elkel53930/daylight/elec/main_board/main_board_outline.dxf

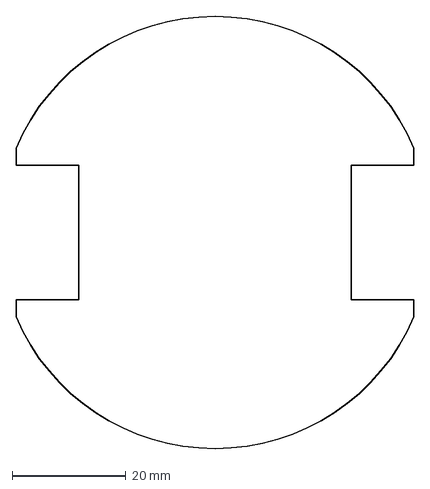
[picture p1: CAD file, 2026-06-27]
elec/main_board/main_board_outline.dxf
70.0 x 76.0 mm
