elkel53930/daylight/elec/main_board/encoder_board_outline.dxf

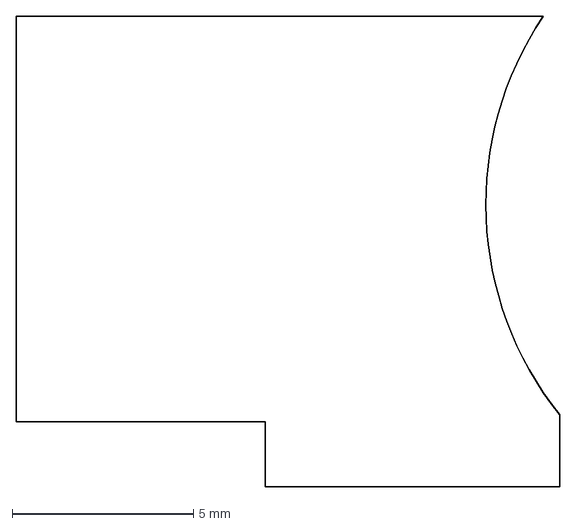
[picture p3: CAD file, 2026-06-28]
elec/main_board/encoder_board_outline.dxf
15.0 x 13.0 mm
