elkel53930/daylight/elec/rpi_board/rpi_board_outline.dxf

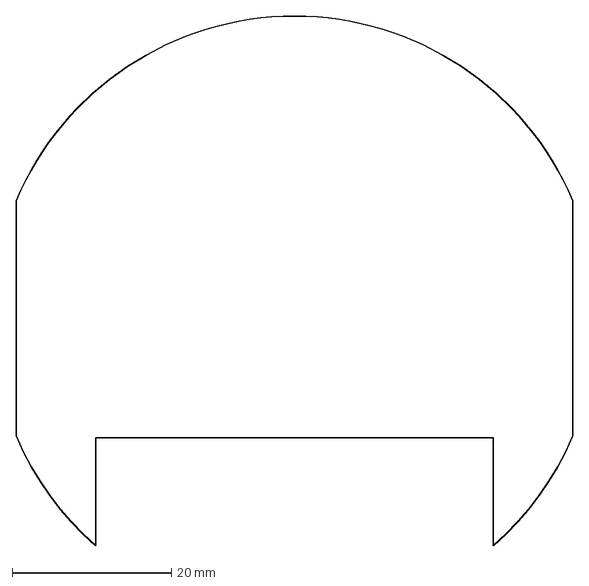
[picture p6: CAD file, 2026-06-28]
elec/rpi_board/rpi_board_outline.dxf
70.0 x 66.6 mm
