elkel53930/daylight/elec/sub_boards/encoder_board_outline.dxf

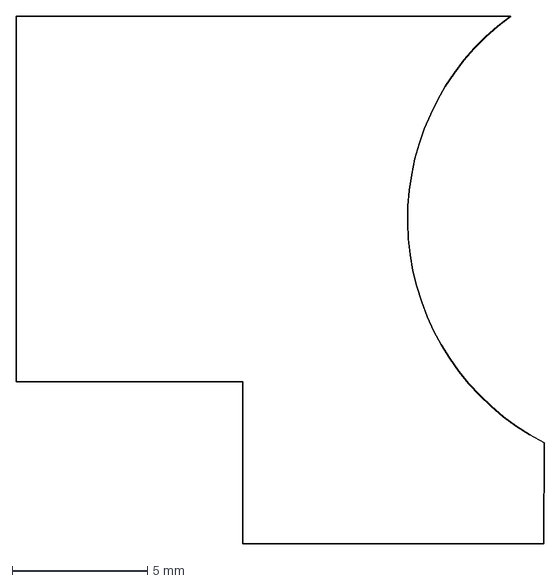
[picture p7: CAD file, 2026-07-31]
elec/sub_boards/encoder_board_outline.dxf
19.5 x 19.5 mm
