elkel53930/daylight/elec/sub_boards/if_board_outline.dxf

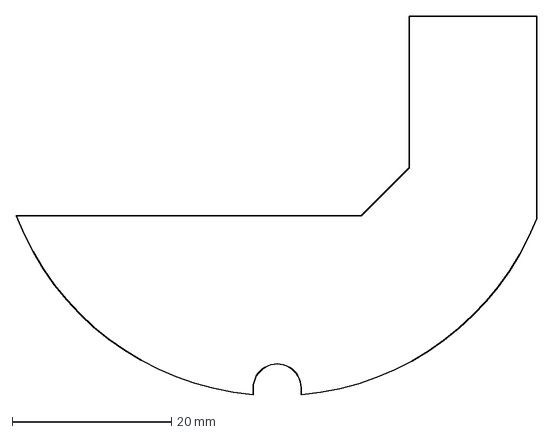
[picture p8: CAD file, 2026-06-28]
elec/sub_boards/if_board_outline.dxf
65.3 x 47.4 mm
