elkel53930/daylight/elec/main_board/encoder_board_drawing.dxf

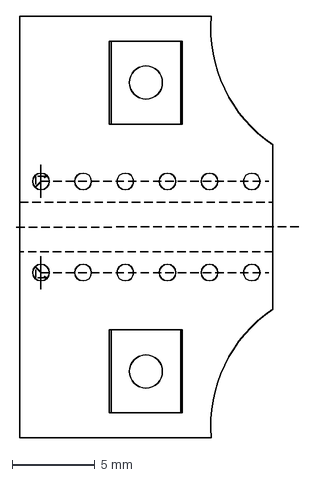
[picture p9: CAD file, 2026-05-14]
elec/main_board/encoder_board_drawing.dxf
17.0 x 25.4 mm
