elkel53930/daylight/elec/sub_boards/if_board_drawing.dxf

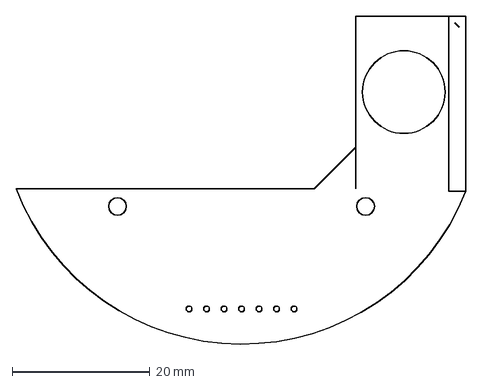
[picture p10: CAD file, 2026-06-28]
elec/sub_boards/if_board_drawing.dxf
65.3 x 47.7 mm
