elkel53930/daylight/elec/sub_boards/sub_boards.kicad_pcb

## KiCad design elec/sub_boards/sub_boards.kicad_pcb (2026-08-02)

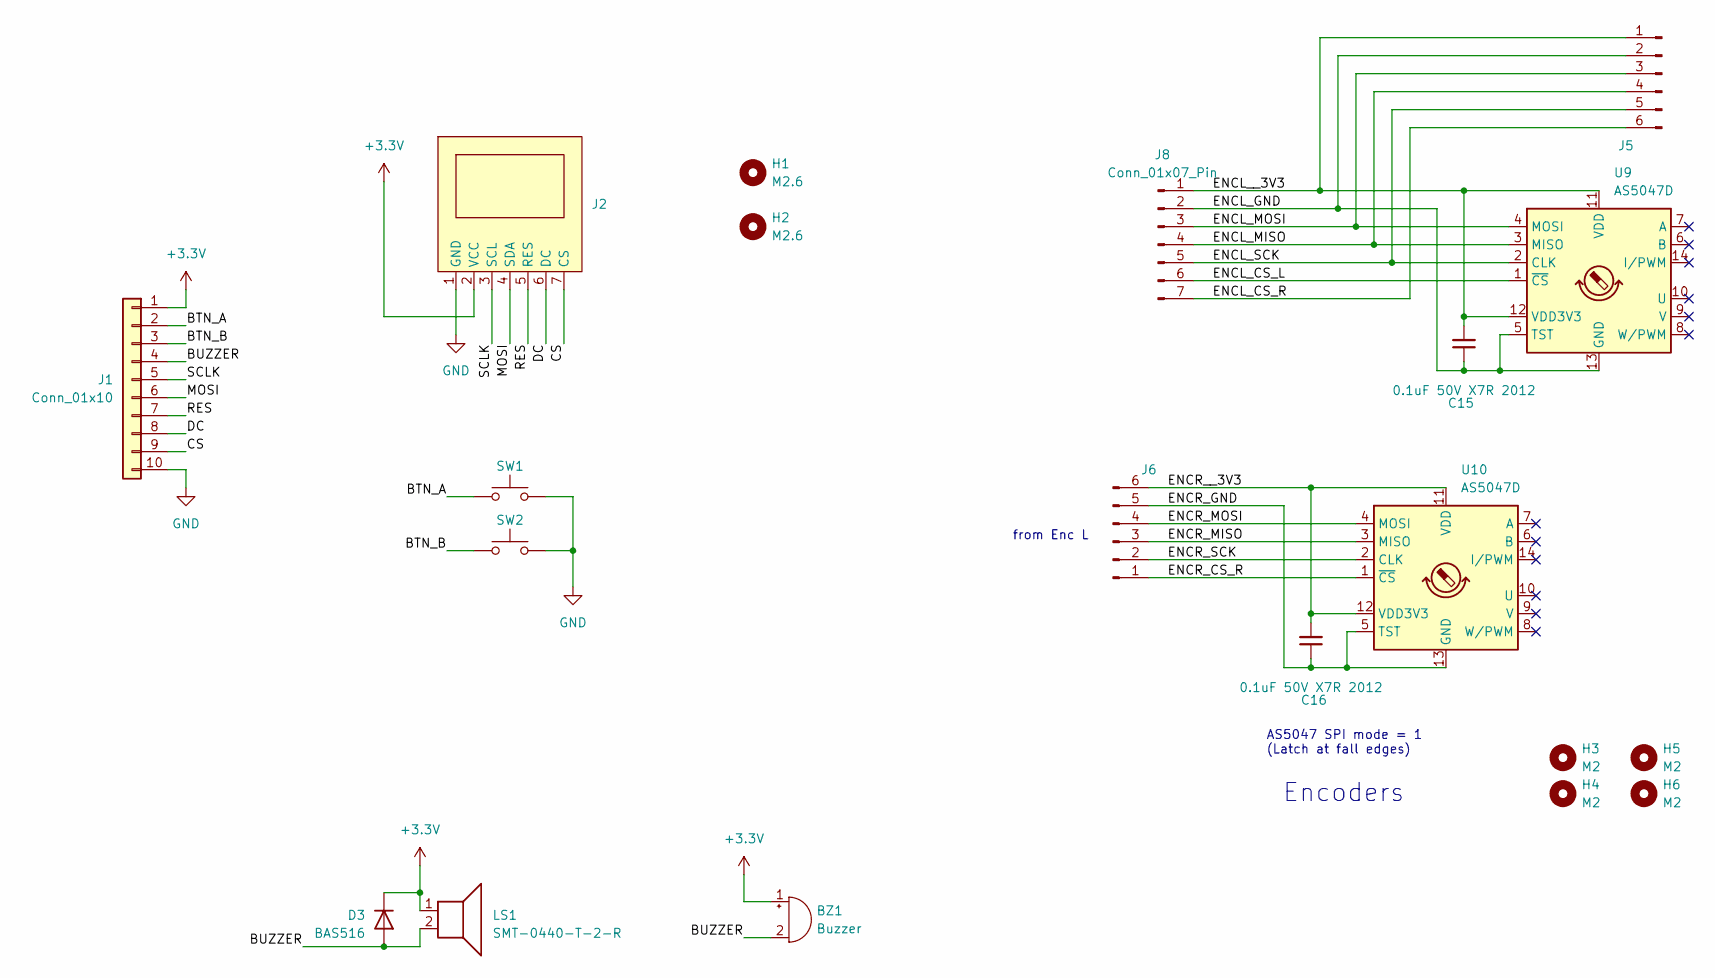
[picture p11: schematic sub_boards.kicad_sch]

Parts:
BZ1: Buzzer; Buzzer_12x9.5RM7.6
C15, C16: C_0805_2012Metric_Pad1.18x1.45mm_HandSolder
D3: BAS516; D_SOD-523
H1, H2: M2.6; MountingHole_2.7mm
H3, H4, H5, H6: M2; MountingHole_2.1mm
J1: Conn_01x10; PinSocket_1x10_P2.54mm_Vertical
J2: PinSocket_1x07_P2.54mm_Vertical
J5, J6: PSR-41253-06O; JST_ZH_B6B-ZR_1x06_P1.50mm_Vertical
J8: Conn_01x07_Pin; JST_ZH_B7B-ZR_1x07_P1.50mm_Vertical
LS1: SMT-0440-T-2-R
SW1, SW2: TVBP06-B043CB-B; SW_PUSH_1P1T_6x3.5mm_H4.3_APEM_MJTP1243
U9, U10: AS5047D; TSSOP-14_4.4x5mm_P0.65mm

Connections:
+3.3V: BZ1.1 (+), D3.1 (K), J1.1, J2.2 (VCC), LS1.1
/BTN_A: J1.2, SW1.1
/BTN_B: J1.3, SW2.1
/BUZZER: BZ1.2 (-), D3.2 (A), J1.4, LS1.2
/CS: J1.9, J2.7 (CS)
/DC: J1.8, J2.6 (DC)
/ENCL_CS_L: J8.6, U9.1 (~CS)
/ENCL_CS_R: J5.6, J8.7
/ENCL_GND: C15.1, J5.2, J8.2, U9.5 (TST), U9.13 (GND)
/ENCL_MISO: J5.4, J8.4, U9.3 (MISO)
/ENCL_MOSI: J5.3, J8.3, U9.4 (MOSI)
/ENCL_SCK: J5.5, J8.5, U9.2 (CLK)
/ENCL__3V3: C15.2, J5.1, J8.1, U9.11 (VDD), U9.12 (VDD3V3)
/ENCR_CS_R: J6.1, U10.1 (~CS)
/ENCR_GND: C16.1, J6.5, U10.5 (TST), U10.13 (GND)
/ENCR_MISO: J6.3, U10.3 (MISO)
/ENCR_MOSI: J6.4, U10.4 (MOSI)
/ENCR_SCK: J6.2, U10.2 (CLK)
/ENCR__3V3: C16.2, J6.6, U10.11 (VDD), U10.12 (VDD3V3)
/MOSI: J1.6, J2.4 (SDA)
/RES: J1.7, J2.5 (RES)
/SCLK: J1.5, J2.3 (SCL)
GND: J1.10, J2.1 (GND), SW1.2, SW2.2

Notes on the sheet:
AS5047 SPI mode = 1 (Latch at fall edges)
from Enc L
Encoders

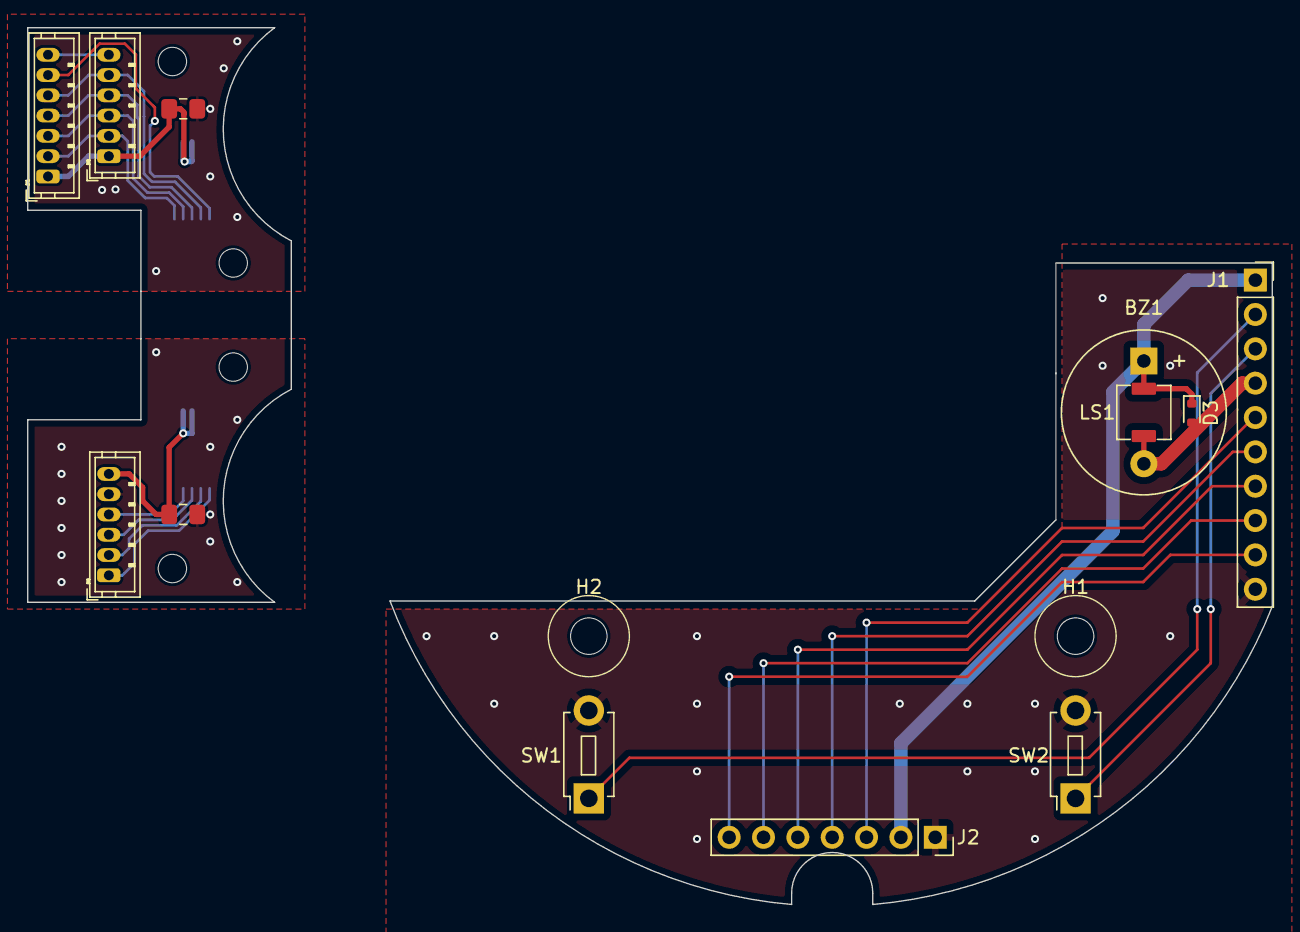
[picture p12: board sub_boards.kicad_pcb from above]

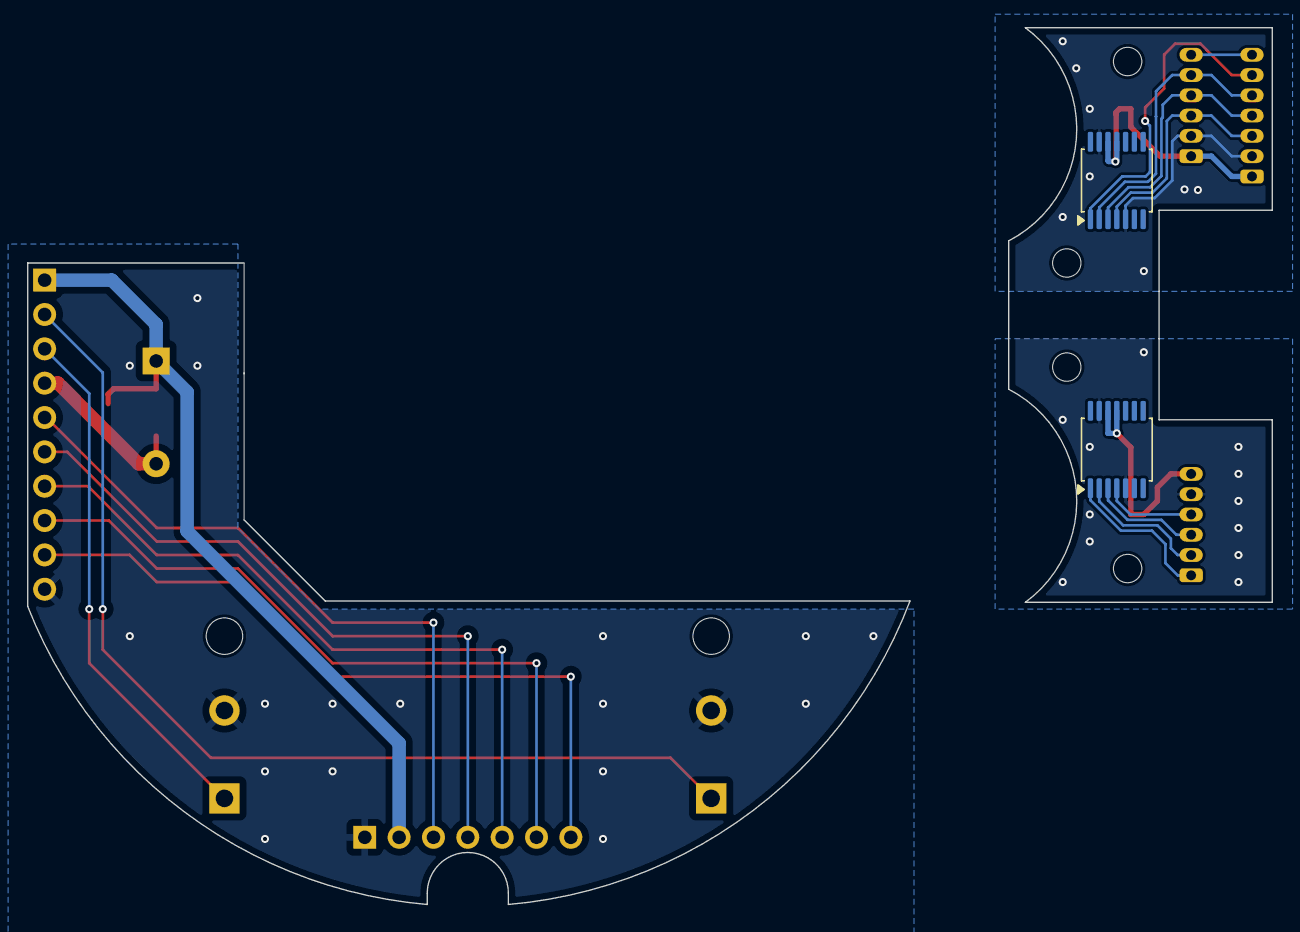
[picture p13: board sub_boards.kicad_pcb from below]

Board: 2 copper layers, 92.0 x 64.8 mm, 20 parts (2 on the bottom side), 23 nets.
