elkel53930/daylight/elec/rpi_board/rpi_board.kicad_pcb

## KiCad design elec/rpi_board/rpi_board.kicad_pcb (2026-06-29)

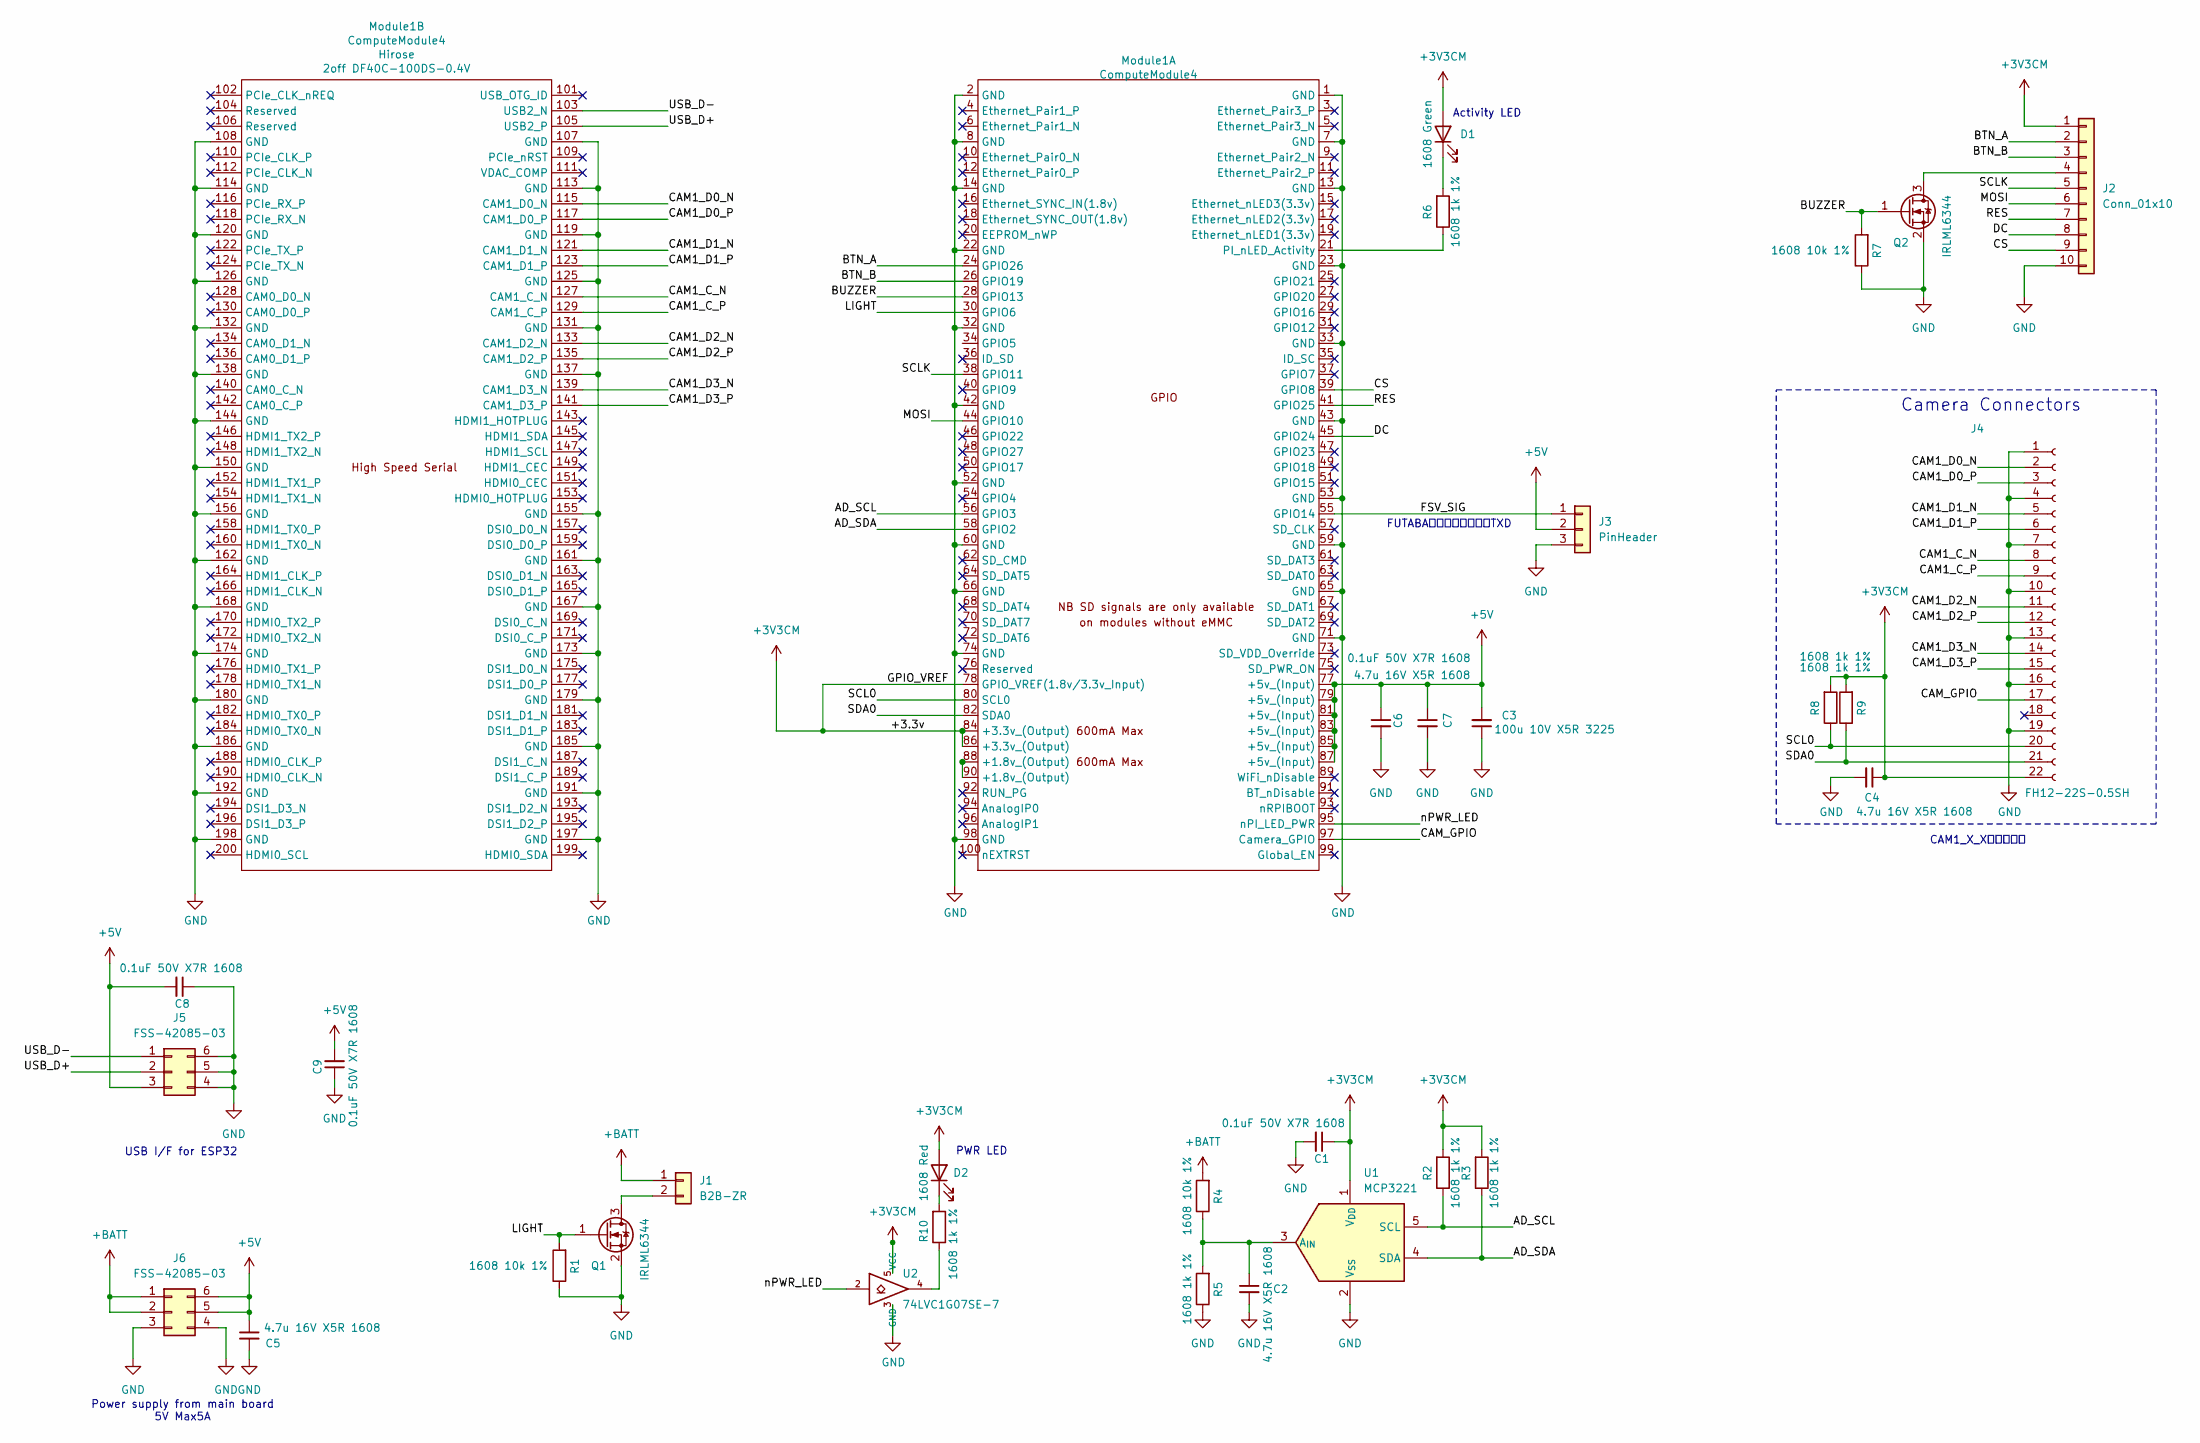
[picture p14: schematic rpi_board.kicad_sch]

Parts:
C1, C6, C8, C9: CC0603KRX7R9BB104; C_0603_1608Metric
C2, C4, C5, C7: CL10A475KO8NNNC; C_0603_1608Metric
C3: CL32A107MPVNNNE; C_1210_3225Metric
D1: D-060306G1/SS2/G1; LED_0603_1608Metric
D2: KT-0603R; LED_0603_1608Metric
J1: B2B-ZR; JST_ZH_B2B-ZR_1x02_P1.50mm_Vertical
J2: Conn_01x10; PinSocket_1x10_P2.54mm_Vertical
J3: PinHeader; PinHeader_1x03_P2.54mm_Vertical
J4: FH12-22S-0.5SH; Hirose_FH12-22S-0.5SH_1x22-1MP_P0.50mm_Horizontal; Part Description 22 Position FFC, FPC Connector Contacts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
J5, J6: FSS-42085-03; PinHeader_2x03_P2.54mm_Vertical
Module1: ComputeModule4; Raspberry-Pi-4-Compute-Module; Part Description 100 Position Connector Receptacle, Cent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
Q1, Q2: IRLML6344; SOT-23
R1, R4, R7: 0603WAF1002T5E; R_0603_1608Metric
R2, R3, R5, R6, R8, R9, R10: 0603WAF1001T5E; R_0603_1608Metric
U1: MCP3221; SOT-23-5
U2: 74LVC1G07SE-7; SOT-353_SC-70-5; Part Description Buffer, Non-Inverting 1 Element 1 Bit p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

Connections:
+3V3CM: C1.1, C4.1, D1.2 (A), D2.2 (A), J2.1, J4.22, Module1.78 (GPIO_VREF(1.8v/3.3v_Input)), Module1.84 (+3.3v_(Output)), Module1.86 (+3.3v_(Output)), R2.2, R3.2, R8.2, R9.2, U1.1 (V_{DD}), U2.5 (VCC)
+5V: C3.2, C5.1, C6.1, C7.1, C8.2, C9.2, J3.2, J5.3, J6.5, J6.6, Module1.77 (+5v_(Input)), Module1.79 (+5v_(Input)), Module1.81 (+5v_(Input)), Module1.83 (+5v_(Input)), Module1.85 (+5v_(Input)), Module1.87 (+5v_(Input))
+BATT: J1.1, J6.1, J6.2, R4.2
/AD_SCL: Module1.56 (GPIO3), R2.1, U1.5 (SCL)
/AD_SDA: Module1.58 (GPIO2), R3.1, U1.4 (SDA)
/BTN_A: J2.2, Module1.24 (GPIO26)
/BTN_B: J2.3, Module1.26 (GPIO19)
/BUZZER: Module1.28 (GPIO13), Q2.1 (G), R7.2
/CAM1_C_N: J4.8, Module1.127 (CAM1_C_N)
/CAM1_C_P: J4.9, Module1.129 (CAM1_C_P)
/CAM1_D0_N: J4.2, Module1.115 (CAM1_D0_N)
/CAM1_D0_P: J4.3, Module1.117 (CAM1_D0_P)
/CAM1_D1_N: J4.5, Module1.121 (CAM1_D1_N)
/CAM1_D1_P: J4.6, Module1.123 (CAM1_D1_P)
/CAM1_D2_N: J4.11, Module1.133 (CAM1_D2_N)
/CAM1_D2_P: J4.12, Module1.135 (CAM1_D2_P)
/CAM1_D3_N: J4.14, Module1.139 (CAM1_D3_N)
/CAM1_D3_P: J4.15, Module1.141 (CAM1_D3_P)
/CAM_GPIO: J4.17, Module1.97 (Camera_GPIO)
/CS: J2.9, Module1.39 (GPIO8)
/DC: J2.8, Module1.45 (GPIO24)
/FSV_SIG: J3.1, Module1.55 (GPIO14)
/LIGHT: Module1.30 (GPIO6), Q1.1 (G), R1.2
/MOSI: J2.6, Module1.44 (GPIO10)
/RES: J2.7, Module1.41 (GPIO25)
/SCL0: J4.20, Module1.80 (SCL0), R8.1
/SCLK: J2.5, Module1.38 (GPIO11)
/SDA0: J4.21, Module1.82 (SDA0), R9.1
/USB_D+: J5.2, Module1.105 (USB2_P)
/USB_D-: J5.1, Module1.103 (USB2_N)
/nPWR_LED: Module1.95 (nPI_LED_PWR), U2.2
GND: C1.2, C2.2, C3.1, C4.2, C5.2, C6.2, C7.2, C8.1, C9.1, J2.10, J3.3, J4.1, J4.4, J4.7, J4.10, J4.13, J4.16, J4.19, J5.4, J5.5, J5.6, J6.3, J6.4, Module1.1 (GND), Module1.2 (GND), Module1.7 (GND), Module1.8 (GND), Module1.13 (GND), Module1.14 (GND), Module1.22 (GND), Module1.23 (GND), Module1.32 (GND), Module1.33 (GND), Module1.42 (GND), Module1.43 (GND), Module1.52 (GND), Module1.53 (GND), Module1.59 (GND), Module1.60 (GND), Module1.65 (GND), Module1.66 (GND), Module1.71 (GND), Module1.74 (GND), Module1.98 (GND), Module1.107 (GND), Module1.108 (GND), Module1.113 (GND), Module1.114 (GND), Module1.119 (GND), Module1.120 (GND), Module1.125 (GND), Module1.126 (GND), Module1.131 (GND), Module1.132 (GND), Module1.137 (GND), Module1.138 (GND), Module1.144 (GND), Module1.150 (GND), Module1.155 (GND), Module1.156 (GND), Module1.161 (GND), Module1.162 (GND), Module1.167 (GND), Module1.168 (GND), Module1.173 (GND), Module1.174 (GND), Module1.179 (GND), Module1.180 (GND), Module1.185 (GND), Module1.186 (GND), Module1.191 (GND), Module1.192 (GND), Module1.197 (GND), Module1.198 (GND), Q1.2 (S), Q2.2 (S), R1.1, R5.1, R7.1, U1.2 (V_{SS}), U2.3 (GND)
unnamed: D1.1 (K), R6.2
unnamed: D2.1 (K), R10.2
unnamed: J1.2, Q1.3 (D)
unnamed: J2.4, Q2.3 (D)
unnamed: Module1.88 (+1.8v_(Output)), Module1.90 (+1.8v_(Output))
unnamed: Module1.21 (PI_nLED_Activity), R6.1
unnamed: R10.1, U2.4
unnamed: C2.1, R4.1, R5.2, U1.3 (A_{IN})

Notes on the sheet:
CAM1_X_Xは等長配線
Camera Connectors
PWR LED
Activity LED
Power supply from main board 5V Max5A
FUTABAサーボモータ用のTXD
USB I/F for ESP32

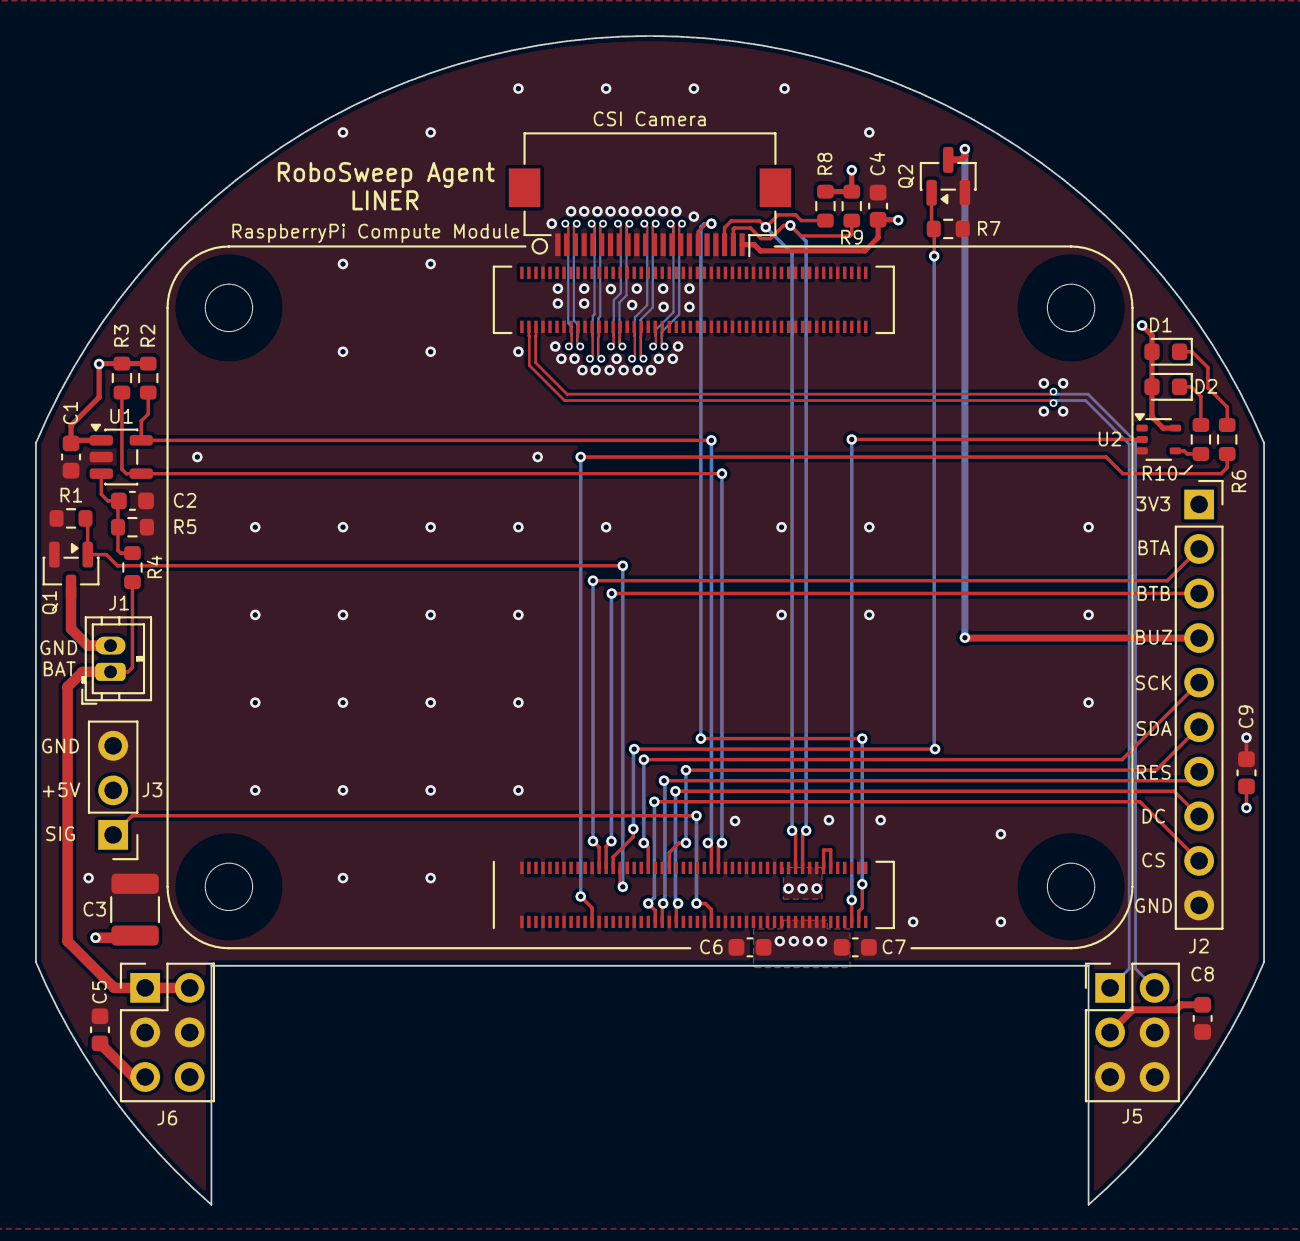
[picture p15: board rpi_board.kicad_pcb from above]

Board: 4 copper layers, 70.0 x 66.6 mm, 32 parts (0 on the bottom side), 40 nets.
