elkel53930/daylight/elec/main_board/main_board.kicad_pcb

## KiCad design elec/main_board/main_board.kicad_pcb (continued)

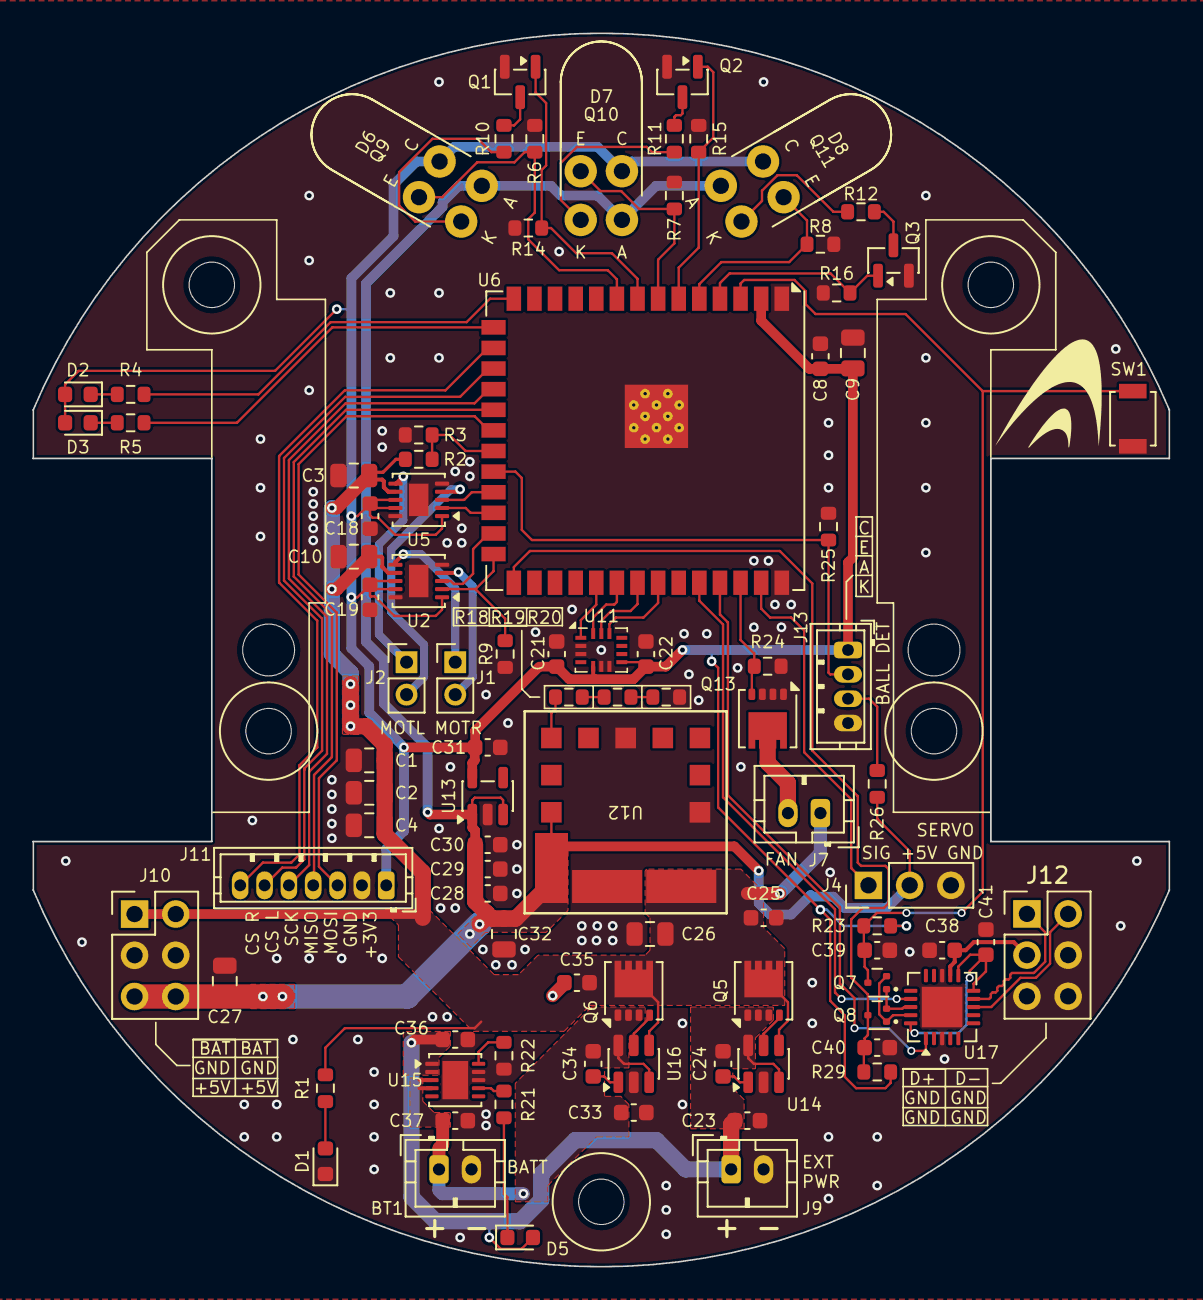
[picture p18: board main_board.kicad_pcb from above]

Board: 2 copper layers, 70.0 x 76.0 mm, 101 parts (0 on the bottom side), 66 nets.
