elkel53930/daylight/software/mob/mob.ino

#include <SPI.h>
#include <WiFi.h>
#include <atomic>
#include <esp_task_wdt.h>
#include "spi_manager.h"
#include "led.h"
#include "wall_sensor.h"
#include "battery.h"
#include "imu.h"
#include "motor.h"
#include "encoder.h"
#include "sensors.h"
#include "motion_controller.h"
#include "place_controller.h"
#include "path_controller.h"
#include "params.h"
#include "fan.h"
#include "servo.h"
#include "ball_sensor.h"
#include <math.h>

// ファームウェアバージョン(VERコマンドで応答)。ロジックに意味のある変更を
// したら必ず上げること(書き込み確認・動作切り分けに使う)。
#define FW_VERSION "0.4.2"

// Target wheel speed [m/s] (updated from MOT command via cmd_queue)
static float target_vr_mps = 0.0f;
static float target_vl_mps = 0.0f;

// Core0が今どのモーションを実行中か。個別boolの組み合わせだと
// 「他の全フラグをfalseにする」処理を新しいモーション追加のたびに
// 手で書く必要があり書き漏れが起きやすいため、単一のenumにして
// 新しい状態への代入1回だけで「他の状態ではない」が構造的に保証される
// ようにしている(2026-07-24導入、2026-08-02にFWD/STOP/TURN等の旧移動系
// 状態を削除しPLACE_HOLDのみに整理)。
enum class MotionState : uint8_t {
    IDLE,
    PLACE_HOLD,   // その場静止制御(place_controller.cpp、2026-08-02〜)
    PATH_FOLLOW,  // 仮想ターゲット追従パス走行(path_controller.cpp、2026-08-02〜)
};
static MotionState motion_state = MotionState::IDLE;

// ジャイロキャリブレーション状態
static bool gyro_calib_done_pending = false;  // キャリブレーション完了時にDONEを返す

// 壁切れ検出(2026-08-03)。走行中、側壁センサが「壁あり↔無し」に変わる縦位置
// (odo_dist)を#WEDGEで出力し、走行中位置補正(壁切れ補正)の較正データを集める。
// ヒステリシス閾値(壁あり>HIGH、無し<LOW)。PRUNのたびにg_wall_edge_resetで
// 検出器の内部状態を現在値から初期化し直す。
static constexpr uint16_t WALL_EDGE_HIGH = 200;
static constexpr uint16_t WALL_EDGE_LOW  = 100;
static bool g_wall_edge_reset = false;

// PRUN完了時のDONE送信フラグ(2026-11-03追加)。
// path_controllerが全セグメントを完了した際に、一度だけDONEを送信する。
// PRUNのたびにリセットされる。
static bool g_path_follow_done_sent = false;

// グローバルなクラスは、上から順に初期化される
Led led;
WallSensor wall_sensor;
IMU imu(get_imu_spi());
Motor motor;
Encoder encoder;
Battery battery;
Sensors sensors(imu, wall_sensor, battery, encoder);
MotionController motion(motor, sensors);
PlaceController place_controller(motor, sensors);
PathController path_controller(motor, sensors);
Fan fan;
Servo servo;
BallSensor ball_sensor;

hw_timer_t* high_speed_timer = NULL;
std::atomic<uint32_t> timer_ticks(0);

QueueHandle_t cmd_queue; // コマンドキュー
QueueHandle_t msg_queue; // Core0 -> Core1 メッセージキュー（Serial出力用）

// ---- Core1(loop) -> Core0(RealtimeTask) コマンド定義 ----
struct SetMotorSpeedCommand {
    int16_t right_speed; // mm/s（互換）
    int16_t left_speed;  // mm/s（互換）
};

struct SetDutyCommand {
    int16_t right_duty; // 生duty（-1023〜+1023、速度PID非経由）
    int16_t left_duty;  // 生duty（-1023〜+1023、速度PID非経由）
};

enum CommandID : uint8_t {
    CMD_SET_MOTOR_SPEED = 0x01,
    CMD_RESET_DISTANCE = 0x06,
    CMD_RESET_ANGLE = 0x07,
    CMD_GYRO_CALIBRATE = 0x09,
    CMD_SET_DUTY_DIRECT = 0x0E,
    CMD_SET_ANGLE = 0x0F,
    CMD_PLACE_HOLD_START = 0x11,
    CMD_TURN = 0x12,
    CMD_JOG_MOVE = 0x13,     // JOGFWD/JOGBACK: ヨー保持のまま前後に指定距離だけ低速並進(到達でDONE)
    CMD_JOG_TURN = 0x14,     // JOGTURN: その場旋回で指定角へ(到達でDONE)
    CMD_PATTERN_RUN = 0x17,  // 走行開始のみ。組み立て(PCLEAR/PADD)はcmd_queueを介さない
};

// PATTERN走行パスの格納先。PCLEAR/PADDはCore1(loop)でこのバッファを直接
// 操作して組み立てる(GCAL/MOT等の即時コマンドが通るcmd_queueとは経路を
// 分離、2026-08-02ユーザー指示)。PRUNで走行開始する際、path_controllerが
// このバッファを内部へコピー(スナップショット)するため、走行中にこの
// バッファを書き換えても現在の走行には影響しない。
static constexpr size_t MAX_PATTERN_SEGMENTS = PathController::MAX_SEGMENTS;
static PathController::Segment g_pattern_segments[MAX_PATTERN_SEGMENTS];
static size_t g_pattern_segment_count = 0;

struct Command {
    CommandID cmd_id;
    union {
        SetMotorSpeedCommand set_motor_speed;
        SetDutyCommand set_duty;
        float set_angle_rad;
        float turn_angle_rad;
        float jog_dist_mm;   // CMD_JOG_MOVE: 正=前進, 負=後退
        float jog_turn_rad;  // CMD_JOG_TURN: 正=左/CCW
    } parameter;
};

// ---- Core0 -> Core1 メッセージ定義（Serial出力用） ----
// Core0->Core1で渡すメッセージ（固定長; 末尾は必ず\0終端）
struct MsgLine {
    char text[64];
};

static inline void enqueue_msg_line(const char* s) {
    if (!msg_queue || !s) return;
    MsgLine m;
    size_t i = 0;
    bool truncated = false;
    for (; i < sizeof(m.text) - 1 && s[i] != '\0'; ++i) {
        m.text[i] = s[i];
    }
    // メッセージが長すぎる場合の検出
    if (s[i] != '\0' && i == sizeof(m.text) - 1) {
        truncated = true;
    }
    m.text[i] = '\0';
    // DONEなど重要なメッセージを確実に送るため、最大10msまで待つ
    (void)xQueueSend(msg_queue, &m, pdMS_TO_TICKS(10));
    
    // 切り捨てが発生した場合は警告を別途送信
    if (truncated) {
        MsgLine warn;
        snprintf(warn.text, sizeof(warn.text), "#WARN: msg truncated\n");
        (void)xQueueSend(msg_queue, &warn, 0);
    }
}

void IRAM_ATTR onHighSpeedTimer() {
    timer_ticks.fetch_add(1, std::memory_order_relaxed);
}

uint32_t waitTick(uint32_t &last_tick) {
    uint32_t current_tick = timer_ticks.load(std::memory_order_relaxed);
    while(current_tick == last_tick) {
        // 待機
        asm volatile("nop");
        current_tick = timer_ticks.load(std::memory_order_relaxed);
    }
    uint32_t delta = current_tick - last_tick;
    last_tick = current_tick;
    return delta;
}

// コマンド処理・モーション更新関数の前方宣言
void handleSetMotorSpeedCommand(const SetMotorSpeedCommand& cmd);
void handleSetDutyCommand(const SetDutyCommand& cmd);
void processCommandQueue();
void updatePlaceHold(float dt_s);
void updatePathFollow(float dt_s);
int split_csv(const String& s, String* out, int max_tokens);

// カンマ区切り文字列をトークン配列に分割する(PADD,STRAIGHT/SLALOMの
// 可変引数パース用)。戻り値は分割できたトークン数(max_tokensで打ち切り、
// 末尾トークンは残り全体)。
int split_csv(const String& s, String* out, int max_tokens) {
    int count = 0;
    int start = 0;
    while (count < max_tokens) {
        int comma = s.indexOf(',', start);
        if (comma < 0) {
            out[count++] = s.substring(start);
            break;
        }
        out[count++] = s.substring(start, comma);
        start = comma + 1;
    }
    return count;
}

// ========================================
// コマンド処理関数の実装
// ========================================

void handleSetMotorSpeedCommand(const SetMotorSpeedCommand& cmd) {
    const float vr = static_cast<float>(cmd.right_speed) / 1000.0f;
    const float vl = static_cast<float>(cmd.left_speed) / 1000.0f;

    // 手動MOTが来たらほかのモーションは停止（競合回避）
    motion_state = MotionState::IDLE;

    target_vr_mps = vr;
    target_vl_mps = vl;
    motion.forward((vr + vl) * 0.5f);
}

void handleSetDutyCommand(const SetDutyCommand& cmd) {
    // 手動DUTYが来たらほかのモーションは停止（競合回避、MOTと同様）
    motion_state = MotionState::IDLE;

    motion.set_duty_direct(cmd.right_duty, cmd.left_duty);
}

void processCommandQueue() {
    Command q;
    while (xQueueReceive(cmd_queue, &q, 0) == pdTRUE) {
        switch (q.cmd_id) {
            case CMD_SET_MOTOR_SPEED:
                handleSetMotorSpeedCommand(q.parameter.set_motor_speed);
                break;

            case CMD_RESET_DISTANCE:
                sensors.reset_distance();
                enqueue_msg_line("#distance reset\n");
                enqueue_msg_line("DONE\n");
                break;

            case CMD_RESET_ANGLE:
                sensors.reset_angle();
                enqueue_msg_line("#angle reset\n");
                enqueue_msg_line("DONE\n");
                break;

            case CMD_SET_ANGLE:
                // 外部の絶対基準(カメラ等)で角度を上書きする。
                // 走行中の制御ループが参照する目標角には触れないため、
                // 呼ぶのは停止中に限ること。
                sensors.set_angle(q.parameter.set_angle_rad);
                enqueue_msg_line("#angle set\n");
                enqueue_msg_line("DONE\n");
                break;

            case CMD_GYRO_CALIBRATE:
                // ジャイロキャリブレーション開始（非ブロッキング）
                enqueue_msg_line("#Gyro calibration start...\n");
                sensors.calibrate_gyro();
                gyro_calib_done_pending = true;
                break;

            case CMD_SET_DUTY_DIRECT:
                handleSetDutyCommand(q.parameter.set_duty);
                break;

            case CMD_PLACE_HOLD_START:
                // 競合回避: ほかのモーションを停止
                motion_state = MotionState::PLACE_HOLD;
                place_controller.start();
                enqueue_msg_line("#PLACE_HOLD: start\n");
                break;

            case CMD_TURN:
                // 競合回避: ほかのモーションを停止
                motion_state = MotionState::PLACE_HOLD;
                place_controller.start_turn(q.parameter.turn_angle_rad);
                enqueue_msg_line("#PLACE_HOLD: turn start\n");
                break;

            case CMD_JOG_MOVE:
                // JOGFWD/JOGBACK: ヨー保持のまま前後に指定距離だけ低速並進。
                // 到達・整定で place_controller が完了を通知(updatePlaceHoldが
                // DONEを送る)。到達後も位置・向きを保持する(停止はMOT,0,0)。
                motion_state = MotionState::PLACE_HOLD;
                place_controller.start_move(q.parameter.jog_dist_mm);
                enqueue_msg_line("#PLACE_HOLD: jog move start\n");
                break;

            case CMD_JOG_TURN:
                // JOGTURN: その場旋回で指定角へ。TURNと同じ台形プロファイルだが
                // 到達・整定でDONEを返す(完了を待てる)。
                motion_state = MotionState::PLACE_HOLD;
                place_controller.start_turn(q.parameter.jog_turn_rad, /*as_jog=*/true);
                enqueue_msg_line("#PLACE_HOLD: jog turn start\n");
                break;

            case CMD_PATTERN_RUN:
                // 競合回避: ほかのモーションを停止。start()内でg_pattern_segmentsを
                // 内部へコピーするので、以後Core1がバッファを触っても走行に影響しない。
                motion_state = MotionState::PATH_FOLLOW;
                path_controller.start(g_pattern_segments, g_pattern_segment_count);
                g_wall_edge_reset = true;  // 壁切れ検出器を走行開始時に初期化
                g_path_follow_done_sent = false;  // DONE送信フラグをリセット(2026-11-03)
                enqueue_msg_line("#PATH_FOLLOW: pattern start\n");
                break;

            default:
                break;
        }
    }
}

void updatePlaceHold(float dt_s) {
    if (motion_state != MotionState::PLACE_HOLD) return;
    place_controller.update(dt_s);

    // JOG(JOGFWD/JOGBACK/JOGTURN)が目標へ到達・整定したら一度だけDONEを返す。
    // 到達後も place_controller は位置・向きの保持を続ける(停止はMOT,0,0)。
    if (place_controller.take_jog_arrived()) {
        enqueue_msg_line("DONE\n");
    }

    static int dbg_count = 0;
    dbg_count++;
    if (dbg_count >= 50) {  // 20Hz
        dbg_count = 0;
        // #P,vr,vl,vsum,duty
        char msg[64];
        snprintf(msg, sizeof(msg), "#P,%.1f,%.1f,%.1f,%d\n",
                 place_controller.get_vr_mps() * 1000.0f,
                 place_controller.get_vl_mps() * 1000.0f,
                 place_controller.get_v_sum_mps() * 1000.0f,
                 place_controller.get_duty());
        enqueue_msg_line(msg);

        if (place_controller.is_turning()) {
            // #A,target_angle,actual_angle,omega_target,duty_diff
            char msg2[64];
            snprintf(msg2, sizeof(msg2), "#A,%.4f,%.4f,%.2f,%d\n",
                     place_controller.get_target_angle_rad(),
                     sensors.get_angle(),
                     place_controller.get_omega_target_radps(),
                     place_controller.get_duty_diff());
            enqueue_msg_line(msg2);
        }
    }
}

void updatePathFollow(float dt_s) {
    if (motion_state != MotionState::PATH_FOLLOW) return;
    path_controller.update(dt_s);

    // 衝突検出(2026-08-09): path_controller が位置/角度誤差の持続逸脱で
    // モーターを停止済み。ここで一度だけ #COLLIDE,<seg>,<dist>,<hdg_err>
    // を通知する(フラグは take_collision() がクリアする)。
    if (path_controller.take_collision()) {
        char m[64];
        snprintf(m, sizeof(m), "#COLLIDE,%u,%.1f,%.3f\n",
                 static_cast<unsigned>(path_controller.get_seg_index()),
                 path_controller.get_dist_to_target_mm(),
                 path_controller.get_heading_error_rad());
        enqueue_msg_line(m);
        return;
    }

    // PRUN完了検出(2026-11-03追加): 全セグメントが完了したら一度だけDONEを送信。
    // これにより、Python側は#TテレメトリをポーリングせずDONEを待つだけでよくなる。
    if (path_controller.all_segments_done() && !g_path_follow_done_sent) {
        enqueue_msg_line("DONE\n");
        g_path_follow_done_sent = true;
    }

    // 壁切れ検出(WALL有効時のみ、1kHz)。側壁センサのヒステリシス立ち上がり/
    // 立ち下がりで #WEDGE,<L|R>,<1=rise|0=fall>,<odo_dist> を出力する。
    // fall(壁あり→無し)が壁切れ補正で使う位置。odo_dist は SEN/RDST と同じ
    // sensors.get_distance()。
    if (wall_sensor.is_enabled()) {
        static bool ls_present = false, rs_present = false, edge_inited = false;
        const uint16_t ls = sensors.get_ls();
        const uint16_t rs = sensors.get_rs();
        if (g_wall_edge_reset || !edge_inited) {
            g_wall_edge_reset = false;
            edge_inited = true;
            ls_present = ls > WALL_EDGE_HIGH;
            rs_present = rs > WALL_EDGE_HIGH;
        }
        const float dist = sensors.get_distance();
        char wm[48];
        if (ls_present && ls < WALL_EDGE_LOW) {
            ls_present = false;
            snprintf(wm, sizeof(wm), "#WEDGE,L,0,%.1f\n", dist);
            enqueue_msg_line(wm);
        } else if (!ls_present && ls > WALL_EDGE_HIGH) {
            ls_present = true;
            snprintf(wm, sizeof(wm), "#WEDGE,L,1,%.1f\n", dist);
            enqueue_msg_line(wm);
        }
        if (rs_present && rs < WALL_EDGE_LOW) {
            rs_present = false;
            snprintf(wm, sizeof(wm), "#WEDGE,R,0,%.1f\n", dist);
            enqueue_msg_line(wm);
        } else if (!rs_present && rs > WALL_EDGE_HIGH) {
            rs_present = true;
            snprintf(wm, sizeof(wm), "#WEDGE,R,1,%.1f\n", dist);
            enqueue_msg_line(wm);
        }
    }

    static int dbg_count = 0;
    dbg_count++;
    if (dbg_count >= 50) {  // 20Hz
        dbg_count = 0;
        // #T,seg,tx,ty,rx,ry,rtheta,dist,hdg_err
        char msg[64];
        snprintf(msg, sizeof(msg), "#T,%u,%.0f,%.0f,%.0f,%.0f,%.3f,%.1f,%.3f\n",
                 static_cast<unsigned>(path_controller.get_seg_index()),
                 path_controller.get_target_x_mm(),
                 path_controller.get_target_y_mm(),
                 path_controller.get_robot_x_mm(),
                 path_controller.get_robot_y_mm(),
                 path_controller.get_robot_theta_rad(),
                 path_controller.get_dist_to_target_mm(),
                 path_controller.get_heading_error_rad());
        enqueue_msg_line(msg);
    }
}

// ========================================
// Core0 リアルタイムタスク
// ========================================

void Core0RealtimeTask(void* parameter) {
    // ハイスピードタイマー(1ms)の初期化
    high_speed_timer = timerBegin(1000); // 1000Hz = 1ms period
    timerAttachInterrupt(high_speed_timer, &onHighSpeedTimer);
    timerAlarm(high_speed_timer, 1, true, 0); // 1ms interval, auto-reload

    uint32_t last_tick = 0;
    uint32_t time_delta = 0;

    while(1){
        // 1msごとの待機
        time_delta = waitTick(last_tick);

        // 停止判定を渡す(前cycleのモーター出力=1ms遅れ、問題なし)。停止中は
        // sensors側で角度積分を凍結し、静止中の残留バイアス積分ドリフトを防ぐ。
        // ただし能動制御中(PLACE_HOLD/PATH_FOLLOW)は凍結してはいけない:
        // 超信地旋回の減速〜角度保持フェーズでは duty が正当に0を通過し、その
        // ときだけ角度積分が凍る→実回転を取りこぼす→角度FBにデッドゾーンが
        // 入り旋回が発振する(2026-08-04判明。d75b108では凍結が無く発振しない
        // ことを実機確認済み)。凍結は全制御器アイドルの真の停車時のみに限る。
        const bool actively_controlled =
            (motion_state == MotionState::PLACE_HOLD || motion_state == MotionState::PATH_FOLLOW);
        sensors.set_stationary(motor.is_stopped() && !actively_controlled);

        // センサーデータの更新
        sensors.update(time_delta);

        // コマンドキューの処理（loop() -> Core0）
        processCommandQueue();

        const float dt_s = static_cast<float>(time_delta) / 1000.0f;

        // motion_stateが単一の排他状態のため、update*は自分の状態で
        // なければ何もせず即returnする。
        updatePlaceHold(dt_s);
        updatePathFollow(dt_s);

        // ジャイロキャリブレーション完了チェック
        if (gyro_calib_done_pending && !sensors.is_calibrating()) {
            gyro_calib_done_pending = false;
            char msg[64];
            float offset = sensors.get_gyro_offset();
            snprintf(msg, sizeof(msg), "#Gyro offset=%.6f rad/s\n", offset);
            enqueue_msg_line(msg);
            enqueue_msg_line("DONE\n");
        }

        // Motion controller update (speed PID)。PLACE_HOLD/PATH_FOLLOW中は
        // place_controller/path_controllerが直接モーターを駆動するため、
        // motion(旧MotionController)側の速度PIDが競合して上書きしないよう
        // ここで止める(motion側の目標vr_ref/vl_refはその間一切更新
        // されないため、素通しすると古い目標値に基づいてduty=0等を
        // 毎tick書き込んでしまう)。
        if (motion_state != MotionState::PLACE_HOLD && motion_state != MotionState::PATH_FOLLOW) {
            motion.update(time_delta);
        }
    }
}

void setup() {
    Serial.begin(3000000);
    delay(100);
    
    // 1. ハードウェアWDT無効化
    disableCore0WDT();
    
    // WiFi/Bluetooth無効化
    WiFi.mode(WIFI_OFF);
    btStop();

    // 共有SPIとペリフェラルの初期化
    init_imu_spi();
    motor.begin();
    encoder.begin();
    imu.begin();
    wall_sensor.begin();
    battery.begin();
    led.begin();
    fan.begin();
    servo.begin();
    ball_sensor.begin();

    // 機体固有パラメータ: NVSに保存済みならそれを読み込む(無ければ
    // params.cppのビルド時デフォルトのまま)
    params_begin();

    // 起動時に赤色LEDを消灯
    led.red_off();

    // コマンドキューの作成
    cmd_queue = xQueueCreate(16, sizeof(Command));
    if (cmd_queue == NULL) {
        Serial.printf("#Failed to create command queue!\n");
        while(1);
    }

    // Core0 -> Core1 メッセージキューの作成
    msg_queue = xQueueCreate(128, sizeof(MsgLine));
    if (msg_queue == NULL) {
        Serial.printf("#Failed to create message queue!\n");
        while(1);
    }

    // Core0でハイスピードタスクを開始
    BaseType_t result = xTaskCreatePinnedToCore(
        Core0RealtimeTask,
        "Core0RT",
        4096,
        NULL,
        configMAX_PRIORITIES - 1,  // 最高優先度
        NULL,
        0  // Core 0
    );
    
    if (result != pdPASS) {
        Serial.println("#Failed to create Core0 task!\n");
        while(1);
    }
    
    Serial.printf("#Core 0 realtime task started\n");
    Serial.printf("#System ready\n");
}
 
// Core1のループ関数
void loop() {
    // Core0からのメッセージ出力（Serial.printfはCore1側でのみ行う）
    {
        MsgLine m;
        while (msg_queue && xQueueReceive(msg_queue, &m, 0) == pdTRUE) {
            Serial.print(m.text);
        }
    }

    // センサーデータ出力は周期送信を止め、PCからの要求に応答して送る方式に変更した
    
    // UARTコマンド受信例
    if (Serial.available()) {
        // e.g. "MOT,100,100\n"
        String cmd = Serial.readStringUntil('\n');
        cmd.trim();

        if (cmd.startsWith("MOT")) {
            // モーター速度設定: MOT,100,100
            // 期待フォーマット: "MOT,<right_speed>,<left_speed>"
            int comma1 = cmd.indexOf(',');
            int comma2 = (comma1 >= 0) ? cmd.indexOf(',', comma1 + 1) : -1;
            if (comma1 > 0 && comma2 > comma1) {
                Command q;
                q.cmd_id = CMD_SET_MOTOR_SPEED;
                q.parameter.set_motor_speed.right_speed = cmd.substring(comma1 + 1, comma2).toInt();
                q.parameter.set_motor_speed.left_speed = cmd.substring(comma2 + 1).toInt();

                if (xQueueSend(cmd_queue, &q, pdMS_TO_TICKS(10)) == pdTRUE) {
                    Serial.printf("#Motor: R=%d, L=%d\n",
                                  q.parameter.set_motor_speed.right_speed,
                                  q.parameter.set_motor_speed.left_speed);
                } else {
                    Serial.printf("#Queue full!\n");
                }
            } else {
                Serial.printf("#Invalid MOT format\n");
            }
        } else if (cmd.startsWith("DUTY,")) {
            // 生duty直接指令（校正・診断用、速度PID非経由）: DUTY,<right_duty>,<left_duty>
            // 範囲: -1023〜+1023
            int comma1 = cmd.indexOf(',');
            int comma2 = (comma1 >= 0) ? cmd.indexOf(',', comma1 + 1) : -1;
            if (comma1 > 0 && comma2 > comma1) {
                Command q;
                q.cmd_id = CMD_SET_DUTY_DIRECT;
                q.parameter.set_duty.right_duty = cmd.substring(comma1 + 1, comma2).toInt();
                q.parameter.set_duty.left_duty = cmd.substring(comma2 + 1).toInt();

                if (xQueueSend(cmd_queue, &q, pdMS_TO_TICKS(10)) == pdTRUE) {
                    Serial.printf("#Duty: R=%d, L=%d\n",
                                  q.parameter.set_duty.right_duty,
                                  q.parameter.set_duty.left_duty);
                } else {
                    Serial.printf("#Queue full!\n");
                }
            } else {
                Serial.printf("#Invalid DUTY format\n");
            }
        } else if (cmd.startsWith("WALL")) {
            // 壁センサLEDの有効/無効: WALL,1 または WALL,0
            int comma1 = cmd.indexOf(',');
            if (comma1 > 0) {
                int en = cmd.substring(comma1 + 1).toInt();
                bool enabled = (en != 0);
                wall_sensor.set_enabled(enabled);
                Serial.printf("#WallSensor enabled=%d\n", enabled ? 1 : 0);
            } else {
                Serial.printf("#Invalid WALL format\n");
            }
        } else if (cmd.startsWith("FAN,")) {
            // 吸引ファンPWM速度指定: FAN,<speed>（0-255、0=停止）
            int comma1 = cmd.indexOf(',');
            if (comma1 > 0) {
                int speed = cmd.substring(comma1 + 1).toInt();
                if (speed < 0) speed = 0;
                if (speed > 255) speed = 255;
                fan.set_speed(static_cast<uint8_t>(speed));
                Serial.printf("#FAN speed=%d\n", speed);
            } else {
                Serial.printf("#Invalid FAN format\n");
            }
        } else if (cmd.startsWith("SRV,")) {
            // RCサーボ角度設定: SRV,<angle>（0-180度）
            int comma1 = cmd.indexOf(',');
            if (comma1 > 0) {
                int angle = cmd.substring(comma1 + 1).toInt();
                if (angle < 0) angle = 0;
                if (angle > 180) angle = 180;
                servo.set_angle(static_cast<uint8_t>(angle));
                Serial.printf("#SRV angle=%d\n", angle);
            } else {
                Serial.printf("#Invalid SRV format\n");
            }
        } else if (cmd == "SRVOFF") {
            // RCサーボのトルクオフ（脱力）
            servo.detach();
            Serial.printf("#SRVOFF\n");
        } else if (cmd.startsWith("BALL,")) {
            // ボールセンサしきい値設定: BALL,<threshold>（0-4095）
            int comma1 = cmd.indexOf(',');
            if (comma1 > 0) {
                int threshold = cmd.substring(comma1 + 1).toInt();
                if (threshold < 0) threshold = 0;
                if (threshold > 4095) threshold = 4095;
                ball_sensor.set_threshold(static_cast<uint16_t>(threshold));
                Serial.printf("#BALL threshold=%d\n", threshold);
            } else {
                Serial.printf("#Invalid BALL format\n");
            }
        } else if (cmd == "PGET") {
            // 全パラメータを列挙: PVAL,<name>,<value> を1行ずつ、
            // 最後に PLISTEND
            for (size_t i = 0; i < PARAM_COUNT; i++) {
                float value = 0.0f;
                params_get(PARAM_TABLE[i].name, value);
                Serial.printf("PVAL,%s,%.6f\n", PARAM_TABLE[i].name, value);
            }
            Serial.printf("PLISTEND\n");
        } else if (cmd.startsWith("PGET,")) {
            // 単一パラメータ取得: PGET,<name>
            String name = cmd.substring(5);
            float value = 0.0f;
            if (params_get(name.c_str(), value)) {
                Serial.printf("PVAL,%s,%.6f\n", name.c_str(), value);
            } else {
                Serial.printf("#Unknown param: %s\n", name.c_str());
            }
        } else if (cmd.startsWith("PSET,")) {
            // パラメータ即時変更(RAM上のみ): PSET,<name>,<value>
            int comma1 = cmd.indexOf(',');
            int comma2 = (comma1 >= 0) ? cmd.indexOf(',', comma1 + 1) : -1;
            if (comma2 > 0) {
                String name = cmd.substring(comma1 + 1, comma2);
                float value = cmd.substring(comma2 + 1).toFloat();
                if (params_set(name.c_str(), value)) {
                    Serial.printf("#PSET %s=%.6f\n", name.c_str(), value);
                } else {
                    Serial.printf("#Unknown param: %s\n", name.c_str());
                }
            } else {
                Serial.printf("#Invalid PSET format\n");
            }
        } else if (cmd == "PSAVE") {
            // 現在のパラメータを丸ごとNVSへ保存(機体固有の恒久設定)
            if (params_save()) {
                Serial.printf("DONE\n");
            } else {
                Serial.printf("#PSAVE failed\n");
            }
        } else if (cmd == "PLOAD") {
            // NVSから読み込みRAMへ反映(未保存の項目は現在値を維持)
            if (!params_load()) {
                Serial.printf("#PLOAD: no saved params\n");
            }
            Serial.printf("DONE\n");
        } else if (cmd == "PRESET") {
            // RAM上のパラメータをビルド時デフォルトへ戻す(NVSは変更しない)
            params_reset_to_defaults();
            Serial.printf("DONE\n");
        } else if (cmd == "HOLD") {
            // HOLD: その場静止制御を開始(左右輪速度の和をゼロへ、place_controller.cpp)
            Command q;
            q.cmd_id = CMD_PLACE_HOLD_START;
            if (xQueueSend(cmd_queue, &q, pdMS_TO_TICKS(10)) == pdTRUE) {
                Serial.printf("#HOLD\n");
            } else {
                Serial.printf("#Queue full!\n");
            }
        } else if (cmd.startsWith("TURN,")) {
            // TURN: その場旋回(角度制御、台形速度プロファイル): TURN,<angle_rad>(正=左/CCW)
            int comma1 = cmd.indexOf(',');
            if (comma1 > 0) {
                Command q;
                q.cmd_id = CMD_TURN;
                q.parameter.turn_angle_rad = cmd.substring(comma1 + 1).toFloat();

                if (xQueueSend(cmd_queue, &q, pdMS_TO_TICKS(10)) == pdTRUE) {
                    Serial.printf("#TURN angle=%.4frad\n", q.parameter.turn_angle_rad);
                } else {
                    Serial.printf("#Queue full!\n");
                }
            } else {
                Serial.printf("#Invalid TURN format\n");
            }
        } else if (cmd.startsWith("JOGFWD,") || cmd.startsWith("JOGBACK,")) {
            // JOGFWD,<mm> / JOGBACK,<mm>: ヨー保持のまま前後へ指定距離だけ
            // 低速並進し、到達・整定でDONEを返す(壁上面位置補正の位置成分
            // 等、精密な微小前後移動用)。距離は絶対値(符号は前進/後退で決定)。
            int comma1 = cmd.indexOf(',');
            if (comma1 > 0) {
                float mm = fabsf(cmd.substring(comma1 + 1).toFloat());
                Command q;
                q.cmd_id = CMD_JOG_MOVE;
                q.parameter.jog_dist_mm = cmd.startsWith("JOGBACK,") ? -mm : mm;
                if (xQueueSend(cmd_queue, &q, pdMS_TO_TICKS(10)) == pdTRUE) {
                    Serial.printf("#JOG move=%.2fmm\n", q.parameter.jog_dist_mm);
                } else {
                    Serial.printf("#Queue full!\n");
                }
            } else {
                Serial.printf("#Invalid JOG format\n");
            }
        } else if (cmd.startsWith("JOGTURN,")) {
            // JOGTURN,<angle_rad>(正=左/CCW): その場旋回で指定角へ回し、到達・
            // 整定でDONEを返す(完了を待てるその場旋回)。
            int comma1 = cmd.indexOf(',');
            if (comma1 > 0) {
                Command q;
                q.cmd_id = CMD_JOG_TURN;
                q.parameter.jog_turn_rad = cmd.substring(comma1 + 1).toFloat();
                if (xQueueSend(cmd_queue, &q, pdMS_TO_TICKS(10)) == pdTRUE) {
                    Serial.printf("#JOG turn=%.4frad\n", q.parameter.jog_turn_rad);
                } else {
                    Serial.printf("#Queue full!\n");
                }
            } else {
                Serial.printf("#Invalid JOGTURN format\n");
            }
        } else if (cmd == "PCLEAR") {
            // PCLEAR: PATTERN走行パスのバッファをクリア(PADDの前に毎回呼ぶ)。
            // 走行コマンドはcmd_queue(GCAL/MOT等の即時コマンド用)を経由せず、
            // ここCore1で専用バッファg_pattern_segmentsを直接操作する
            // (2026-08-02、ユーザー指示: 走行コマンドと即時コマンドの処理を分離)。
            g_pattern_segment_count = 0;
            Serial.printf("#PCLEAR\n");
            Serial.printf("DONE\n");
        } else if (cmd.startsWith("PADD,STRAIGHT,")) {
            // PADD,STRAIGHT,<distance_mm>,<v_start_mmps>,<v_cruise_mmps>,<v_end_mmps>
            String tok[6];
            int n = split_csv(cmd, tok, 6);
            if (n != 6) {
                Serial.printf("#Invalid PADD,STRAIGHT format\n");
            } else if (g_pattern_segment_count >= MAX_PATTERN_SEGMENTS) {
                Serial.printf("#PATTERN: buffer full\n");
            } else {
                PathController::Segment& seg = g_pattern_segments[g_pattern_segment_count++];
                seg.type = PathController::SegmentType::STRAIGHT;
                seg.distance_mm = tok[2].toFloat();
                seg.v_start_mmps = tok[3].toFloat();
                seg.v_cruise_mmps = tok[4].toFloat();
                seg.v_end_mmps = tok[5].toFloat();
                seg.v_mmps = 0.0f;
                seg.dir = 0.0f;
                seg.radius_mm = 0.0f;
                seg.angle_rad = 0.0f;
                Serial.printf("#PADD STRAIGHT\n");
                Serial.printf("DONE\n");
            }
        } else if (cmd.startsWith("PADD,SLALOM,")) {
            // PADD,SLALOM,<v_mmps>,<L|R>,<radius_mm>,<angle_deg>(度指定、桁数節約のためradではなくdeg)
            String tok[6];
            int n = split_csv(cmd, tok, 6);
            if (n != 6 || (tok[3] != "L" && tok[3] != "R")) {
                Serial.printf("#Invalid PADD,SLALOM format\n");
            } else if (g_pattern_segment_count >= MAX_PATTERN_SEGMENTS) {
                Serial.printf("#PATTERN: buffer full\n");
            } else {
                PathController::Segment& seg = g_pattern_segments[g_pattern_segment_count++];
                seg.type = PathController::SegmentType::SLALOM;
                seg.distance_mm = 0.0f;
                seg.v_start_mmps = 0.0f;
                seg.v_cruise_mmps = 0.0f;
                seg.v_end_mmps = 0.0f;
                seg.v_mmps = tok[2].toFloat();
                seg.dir = (tok[3] == "L") ? 1.0f : -1.0f;
                seg.radius_mm = tok[4].toFloat();
                seg.angle_rad = tok[5].toFloat() * DEG_TO_RAD;
                Serial.printf("#PADD SLALOM\n");
                Serial.printf("DONE\n");
            }
        } else if (cmd == "PRUN") {
            // PRUN: PCLEAR/PADDで組み立てたPATTERN走行パスを開始
            Command q;
            q.cmd_id = CMD_PATTERN_RUN;
            if (xQueueSend(cmd_queue, &q, pdMS_TO_TICKS(10)) == pdTRUE) {
                Serial.printf("#PRUN\n");
            } else {
                Serial.printf("#Queue full!\n");
            }
        } else if (cmd == "PLIST") {
            // PLIST: 現在積まれているPATTERN走行セグメントを読み返す
            // (PADDのパース結果を検証するためのデバッグ用、2026-08-02追加)。
            // 角度はrad表示(度で送った値がrad変換されているか確認する用)。
            // 静止時(PADD完了後・PRUN前)に呼ぶ前提でロックはしていない。
            Serial.printf("#PSEGCOUNT,%u\n", (unsigned)g_pattern_segment_count);
            for (size_t i = 0; i < g_pattern_segment_count; i++) {
                const PathController::Segment& s = g_pattern_segments[i];
                if (s.type == PathController::SegmentType::STRAIGHT) {
                    Serial.printf("#PSEG,%u,STRAIGHT,dist=%.2f,vs=%.1f,vc=%.1f,ve=%.1f\n",
                        (unsigned)i, s.distance_mm, s.v_start_mmps, s.v_cruise_mmps, s.v_end_mmps);
                } else {
                    Serial.printf("#PSEG,%u,SLALOM,v=%.1f,dir=%.1f,r=%.1f,ang=%.5f\n",
                        (unsigned)i, s.v_mmps, s.dir, s.radius_mm, s.angle_rad);
                }
            }
            Serial.printf("PLISTEND\n");
        } else if (cmd == "RDST") {
            // 距離リセット（オドメトリ）
            Command q;
            q.cmd_id = CMD_RESET_DISTANCE;
            if (xQueueSend(cmd_queue, &q, pdMS_TO_TICKS(10)) == pdTRUE) {
                Serial.printf("#RDST\n");
            } else {
                Serial.printf("#Queue full!\n");
            }
        } else if (cmd == "RANG") {
            // 角度リセット（オドメトリ）
            Command q;
            q.cmd_id = CMD_RESET_ANGLE;
            if (xQueueSend(cmd_queue, &q, pdMS_TO_TICKS(10)) == pdTRUE) {
                Serial.printf("#RANG\n");
            } else {
                Serial.printf("#Queue full!\n");
            }
        } else if (cmd.startsWith("SANG,")) {
            // 角度上書き（外部の絶対基準での補正用）: SANG,<angle_rad>
            int comma1 = cmd.indexOf(',');
            if (comma1 > 0) {
                Command q;
                q.cmd_id = CMD_SET_ANGLE;
                q.parameter.set_angle_rad = cmd.substring(comma1 + 1).toFloat();

                if (xQueueSend(cmd_queue, &q, pdMS_TO_TICKS(10)) == pdTRUE) {
                    Serial.printf("#SANG angle=%.4frad\n", q.parameter.set_angle_rad);
                } else {
                    Serial.printf("#Queue full!\n");
                }
            } else {
                Serial.printf("#Invalid SANG format\n");
            }
        } else if (cmd == "GCAL") {
            // ジャイロキャリブレーション
            Command q;
            q.cmd_id = CMD_GYRO_CALIBRATE;
            if (xQueueSend(cmd_queue, &q, pdMS_TO_TICKS(10)) == pdTRUE) {
                Serial.printf("#GCAL\n");
            } else {
                Serial.printf("#Queue full!\n");
            }
        } else if (cmd == "SEN") {
            // PCからの要求に応答して1行だけSENを送る
            float gyro = sensors.get_gyro_z();      // rad/s
            float vbatt = sensors.get_battery_voltage();
            uint16_t lf = sensors.get_lf();
            uint16_t ls = sensors.get_ls();
            uint16_t rs = sensors.get_rs();
            uint16_t rf = sensors.get_rf();
            uint16_t enc_r = sensors.get_right_wheel_angle();
            uint16_t enc_l = sensors.get_left_wheel_angle();
            float odo_dist = sensors.get_distance();
            float odo_ang = sensors.get_angle();    // rad
            uint16_t ball_raw = ball_sensor.read_raw();
            bool ball_det = ball_sensor.detect();
            Serial.printf("SEN,%.2f,%.2f,%u,%u,%u,%u,%u,%u,%.2f,%.2f,%u,%u\n",
                          gyro, vbatt, lf, ls, rs, rf, enc_r, enc_l, odo_dist, odo_ang,
                          ball_raw, ball_det ? 1 : 0);
        } else if (cmd == "VER") {
            // ファームウェアバージョン確認: VER → VER,<version>,<build date time>
            Serial.printf("VER,%s,%s %s\n", FW_VERSION, __DATE__, __TIME__);
        } else {
            // デバッグ用: 不明コマンド
            Serial.printf("#Unknown cmd: %s\n", cmd.c_str());
        }
    }
    
    delay(1);
}
