elkel53930/daylight/software/fastrun/recenter_cli.py

#!/usr/bin/env python3
"""壁上面補正を実機で実行する簡易CLI。"""
from __future__ import annotations

import argparse
import math
import sys
import time
from pathlib import Path

sys.path.insert(0, str(Path(__file__).resolve().parent))

from camera_align import OnboardCamera
from dev_maze import build_dev_maze
from geometry import Direction
from liner_center import recenter_cell
from liner_pose import LinerPose, direction_to_gyro_deg
from mob_link import MobLink


def main() -> None:
    ap = argparse.ArgumentParser(description="Liner の壁上面補正を実行")
    ap.add_argument("--port", default="/dev/ttyUSB0", help="mob のシリアルポート")
    ap.add_argument("--cell", default="0,0", help='現在セル "x,y"')
    ap.add_argument("--dir", default="N", choices=[d.name for d in Direction], help="現在向き")
    ap.add_argument("--maze", choices=["dev"], default="dev", help="迷路定義(dev=開発用4x4)")
    args = ap.parse_args()

    if args.maze == "dev":
        maze = build_dev_maze()
    else:
        raise SystemExit("未対応の maze 指定です")

    x, y = map(int, args.cell.split(","))
    pose = LinerPose(x, y, Direction[args.dir])

    print(f"start recenter: port={args.port} cell=({x},{y}) dir={args.dir}")
    with MobLink(args.port) as link, OnboardCamera() as cam:
        # --dir で指定した実向きを odo_ang の絶対方位へ貼り直す。
        # turn_to() は odo_ang 基準なので、ここを合わせないと物理方位がずれる。
        init_heading_deg = direction_to_gyro_deg(Direction[args.dir])
        link.stop()
        time.sleep(0.15)
        link.send(f"SANG,{math.radians(init_heading_deg):.5f}")
        if link.wait_for("DONE", timeout_s=1.0) is None:
            raise RuntimeError("SANG failed: initial heading sync timed out")
        print(f"heading synced from --dir: {args.dir} ({init_heading_deg:+.1f} deg)")

        result = recenter_cell(link, cam, maze, pose)

        for axis in ("y", "x"):
            r = result.get(axis)
            if r is None:
                print(f"camera[{axis}] no wall face available")
                continue
            yaw_txt = "n/a" if r.camera_yaw_deg is None else f"{r.camera_yaw_deg:+.2f}"
            dist_txt = "n/a" if r.camera_dist_mm is None else f"{r.camera_dist_mm:.1f}"
            row_txt = "n/a" if r.camera_row_calib is None else f"{r.camera_row_calib:.1f}"
            print(
                f"camera[{axis}] face={r.face.name} dist_mm={dist_txt} yaw_deg={yaw_txt} "
                f"offset_mm={r.offset_mm:+.1f} row_calib={row_txt} ok={r.ok}"
            )

        # 終了時に ESP32 側の継続制御を確実にオフにする。
        print("send stop command to ESP32")
        link.stop()
        time.sleep(0.15)
    print("recenter done")


if __name__ == "__main__":
    main()
