elkel53930/daylight/software/fastrun/camera_align.py

"""camera_align.py — 走行前カメラ初期姿勢補正(Phase 2、2026-08-03〜)。

搭載カメラ(Picamera2、前方固定 Futabaサーボ角0度)で前壁の赤帯上端エッジを
検出し、機体のヨー角ズレ・前壁までの距離オフセットを推定する。ヨー角は
現行ファームの TURN(その場旋回)+ SANG(積分角度の絶対上書き)で物理的に
真っ直ぐへ補正する。距離オフセットは走行計画の最初の直進へ織り込む方針
(現行ファームに精密な微小前進プリミティブが無いため。JOGFWD等は
2026-08-02に削除済み)。

推定ロジック・較正定数は削除済み software/micromouse/camera_correction.py
(git d75afa7、2026-07-24に実機較正)から移植。ただし補正の実行手段
(jog_turn/jog_forward/correct_angle)は現行ファームに無いため作り直した。

⚠️ 較正定数は特定のカメラ解像度(2304x1296)・サーボ角0・マウント位置で
フィットしたもの。撮影は必ず同解像度・中央50%クロップで行うこと。マウントを
触った後は estimate_pose の符号・スケールを実機で再検証してから補正に使う。
"""

from __future__ import annotations

import math
import time
from dataclasses import dataclass
from typing import Optional

import numpy as np

from vision_wall import detect_red_band_top_edge

# --- ヨー角較正(2026-08-03、ジャイロを真値にしたスロープ・スイープで再較正) ---
# 手法: 前壁に正対した状態を基準(RANG=0)に、TURNで既知の相対角(-8〜0deg)へ
# 回しながら赤帯上端エッジの傾き slope_deg=degrees(atan(edge.slope)) を記録し、
# slope_deg = SLOPE_DEG_PER_YAW_DEG * yaw_deg + STRAIGHT_SLOPE_DEG を最小二乗フィット
# (res<2pxの清浄点のみ)。yaw_deg は「壁への正対からのズレ角[deg]、正=左/CCW」。
#   => 正対(yaw=0)へ戻すには TURN で -yaw_deg 回す。
# 旧micromouse較正(gain相当0.532/2026-07-24の9点)はこの機体・距離では約2倍
# ずれており、旧定数で「yaw=0へ補正」すると逆に約4°ずらしていた(実機確認)。
# ⚠️ ゲインは壁までの距離に依存する(近いほど同じ角度で傾きが大きく出る)。
# この値は「前壁まで約1セル」で取得。別距離で使うなら要再較正(距離依存の
# モデル化は今後の課題)。左(+)へ向けると中央クロップに隣の壁が混入して
# フィットが壊れる(res急増)ため、負側+0付近の清浄点で較正した。
SLOPE_DEG_PER_YAW_DEG = 0.248   # d(slope_deg)/d(yaw_deg) @ 約1セル
STRAIGHT_SLOPE_DEG = 0.203      # 正対(yaw=0)時の赤帯slope[deg]

# --- ヨー角較正(半セル≈90mm、2026-08-03) ---
# セル・センタリングでは前壁がマス前縁・側壁がマス側縁にあり、正対距離は
# 半セル(≈90mm)になる。1セル用のgainでは大きくずれる(距離依存)。マス中心・
# 北向きに置いた機体をGCAL/RANG→TURNで東壁正面(gyro基準の真の垂直)にし、
# 保持を切らずCCW側(清浄側)へ+2°刻み6点スイープして再較正した(全点k=5/5・
# spread≈0.03°・スイープ中drift+0.5mm・fit RMS=0.20°)。gainは1セル(0.248)の
# 約3.4倍。詳細な検証経緯は fastrun-project メモ参照。
SLOPE_DEG_PER_YAW_DEG_HALFCELL = 0.840
STRAIGHT_SLOPE_DEG_HALFCELL = 0.973

# --- ヨー角較正(半セル、下端エッジ、2026-08-04) ---
# 位置成分に続きヨー成分も下端エッジ(wall_bottom)へ切替(背景・照明汚染に強い。
# 実測: 暗い赤み照明で上端res157失敗・下端res1.3清浄)。(1,3)平らな北壁で、前回
# 正対時のSANG,0がジャイロ凍結で保持された状態を正対基準に、ジャイロ角±6°を掃引して
# 下端slope_deg=gain*yaw+straight を最小二乗(7/7清浄、fit RMS=0.126°)。
SLOPE_DEG_PER_YAW_DEG_HALFCELL_BOTTOM = 0.6871
STRAIGHT_SLOPE_DEG_HALFCELL_BOTTOM = 0.8870

# --- 距離較正(⚠️stale・位置補正には使わないこと) ---
# 旧micromouse定数のまま。dist_offset_mm は「基準距離からの前進オフセット」で、
# ヨー角較正と同様この機体・距離では未検証。当面は計測・ログのみに使い、
# 走行計画へ織り込む距離補正には使わない(2026-08-03)。
# ⚠️ この gain(11.599 px/mm)は現行カメラ・crop0.5 では約2倍ずれている。
# 2026-08-03 に専用治具で取り直した正しい距離較正は recenter.py の
# CAMERA_ROW_PX_PER_MM=5.38 / CAMERA_ROW_AT_90MM=689.9(crop0.3)。壁上面位置補正
# の位置成分は recenter.forward_offset_from_row / estimate_forward_offset を使う。
# この estimate_pose の dist_offset_mm は角度成分の is_confident(check_dist=False)
# 用途でしか呼ばれておらず(実運用は全て check_dist=False)、位置移動には未使用。
# (2026-08-04 追記: scratchpad試験のX軸23mm行き過ぎはタイヤ滑りではなくこの
#  stale gain が主因と推定。滑りは実測≈1mm/360°と小さいことを確認済み。)
CAMERA_DIST_GAIN_PX_PER_MM = 11.599
CAMERA_DIST_INTERCEPT_PX = 691.55

# 信頼度ゲート(residual が主。左向きで別の壁が混入した不良フィットを弾く)
CAMERA_CORRECTION_MAX_RESIDUAL_PX = 2.0
CAMERA_CORRECTION_MAX_YAW_DEG = 15.0
CAMERA_CORRECTION_MAX_DIST_MM = 40.0

# 較正時の基準解像度。row系の較正定数(row@90mm・px/mm 等)は「高さ CALIB_HEIGHT
# 換算の row」で表す。実際の撮影がこれより小さくても、検出側で
# row_at_center を CALIB_HEIGHT へスケールして使うので較正はそのまま有効
# (slope=傾きは解像度不変なのでヨー較正はスケール不要)。
CALIB_WIDTH = 2304
CALIB_HEIGHT = 1296

# 実際の撮影解像度(2026-08-04、高速化: 高解像度キャプチャ取得が遅いのを軽減)。
# CALIB の正確に 1/3(16:9維持=歪みなし)。row は検出側で CALIB_HEIGHT へ戻す。
DETECT_WIDTH = 768
DETECT_HEIGHT = 432


@dataclass(frozen=True)
class PoseEstimate:
    yaw_deg: float          # 正=機体が左(CCW)を向いている
    dist_offset_mm: float   # 正=基準より前進方向へ余分にいる
    residual_px: float
    inlier_count: int


def estimate_pose(
    img: np.ndarray,
    *,
    slope_gain: float = SLOPE_DEG_PER_YAW_DEG,
    straight_slope: float = STRAIGHT_SLOPE_DEG,
    crop_frac: float = 0.5,
    detector=detect_red_band_top_edge,
) -> Optional[PoseEstimate]:
    """RGB画像(H,W,3 uint8)から推定ヨー角・距離オフセットを求める。

    中央 crop_frac 幅クロップ(画面端の別の壁を巻き込まないため)→ 赤帯上端
    エッジ検出。検出できなければ None。

    slope_gain/straight_slope は壁までの距離に応じた較正定数。既定は約1セル
    距離。センタリング等で半セル(≈90mm)の壁を見るときは *_HALFCELL を渡す。

    crop_frac: 中央クロップの幅割合(既定0.5)。側壁に正対して補正するときは
    機体の向きによって隣の壁が中央付近まで写り込みフィットが壊れるため、
    狭く(例0.3)して隣壁混入を減らせる。ヨーは赤帯slope[deg]から求まり、
    slope[deg] はクロップ幅に不変なので gain/intercept 較正はそのまま使える
    (距離=row_at_center はクロップ幅依存なので dist を使う用途では要注意)。
    """
    h, w, _ = img.shape
    half = max(0.05, min(0.5, crop_frac / 2.0))
    lo = int(round(w * (0.5 - half)))
    hi = int(round(w * (0.5 + half)))
    cropped = np.ascontiguousarray(img[:, lo:hi, :])

    edge = detector(cropped)
    if edge is None:
        return None

    slope_deg = math.degrees(math.atan(edge.slope))
    yaw_deg = (slope_deg - straight_slope) / slope_gain

    cropped_width = cropped.shape[1]
    # row は較正基準(CALIB_HEIGHT)換算にスケール。撮影が小さくても較正定数を
    # そのまま使える(slope=傾きは不変なのでヨーはスケール不要)。
    row_scale = CALIB_HEIGHT / h
    row_at_center = (edge.slope * (cropped_width / 2) + edge.intercept) * row_scale
    dist_offset_mm = (
        row_at_center - CAMERA_DIST_INTERCEPT_PX
    ) / CAMERA_DIST_GAIN_PX_PER_MM

    return PoseEstimate(
        yaw_deg=yaw_deg,
        dist_offset_mm=dist_offset_mm,
        residual_px=edge.residual_std,
        inlier_count=edge.inlier_count,
    )


def is_confident(estimate: PoseEstimate, *, check_dist: bool = True) -> bool:
    """較正範囲から大きく外れた(=信頼できない)推定値を弾く。

    check_dist=False のとき距離ゲートを外す。距離較正は約1セル用のため、
    半セル(センタリングのヨー補正)では dist_offset_mm が範囲外になる。
    ヨー補正だけを行う用途では距離ゲートを無効化して使う。
    """
    ok = (
        estimate.residual_px <= CAMERA_CORRECTION_MAX_RESIDUAL_PX
        and abs(estimate.yaw_deg) <= CAMERA_CORRECTION_MAX_YAW_DEG
    )
    if check_dist:
        ok = ok and abs(estimate.dist_offset_mm) <= CAMERA_CORRECTION_MAX_DIST_MM
    return ok


class OnboardCamera:
    """搭載カメラ(Picamera2)+ 前方固定サーボ。撮影のみを担う。

    初期化コストが大きいため1度だけ生成して使い回す(camera_test.pyと同方針)。
    サーボは論理角0度(前方固定)にしてカメラの向きを走行時と揃える。
    """

    def __init__(self, width: int = DETECT_WIDTH, height: int = DETECT_HEIGHT,
                 move_servo: bool = True):
        import sys
        from pathlib import Path

        sys.path.insert(0, str(Path(__file__).resolve().parent.parent / "arm"))
        self._servo = None
        if move_servo:
            from futaba_servo import FutabaServo

            self._servo = FutabaServo()
            self._servo.set_torque(True)
            # 再現性向上のワンクッション: 一度20度へ動かしてから0度へ戻す
            # (ユーザー指摘のFutabaサーボのクセ。0度未満にはしない)。
            self._servo.set_angle(20.0, move_time_ms=400)
            time.sleep(0.5)
            self._servo.set_angle(0.0, move_time_ms=500)
            time.sleep(0.8)

        from picamera2 import Picamera2

        self._cam = Picamera2()
        # raw センサーモードを較正時(CALIB)に固定し、main だけ縮小して ISP で
        # ダウンスケールする。こうしないと小さい main サイズで別のセンサーモード
        # (FOVが違う=クロップ)が選ばれ、row の単純スケールが合わなくなる
        # (2026-08-04、768x432で実測 row が1.36倍ずれたため修正)。
        cfg = self._cam.create_still_configuration(
            main={"size": (width, height), "format": "RGB888"},
            raw={"size": (CALIB_WIDTH, CALIB_HEIGHT)},
        )
        self._cam.configure(cfg)
        self._cam.start()
        time.sleep(1.0)  # 露出安定待ち

    def capture(self) -> np.ndarray:
        """1枚撮影して RGB(H,W,3) を返す。"""
        array = self._cam.capture_array("main")
        return array[:, :, ::-1]  # RGB888 の capture_array は numpy 上 BGR 並び

    def close(self) -> None:
        try:
            self._cam.stop()
        except Exception:
            pass
        if self._servo is not None:
            self._servo.close()

    def __enter__(self) -> "OnboardCamera":
        return self

    def __exit__(self, *exc) -> None:
        self.close()


def _turn_by(link, turn_rad: float, *, settle_s: float = 0.6, hold: bool = True) -> None:
    """TURN で相対 turn_rad だけ回し、旋回時間ぶん待つ。

    hold=True(既定)では stop() を呼ばず、TURN の並進+角度保持を効かせたまま
    にする。旋回を連続で行うとき各回の間に MOT,0,0 で保持を切ると、
    place_controller が次の start_turn で drift した現在位置を新基準に
    再アンカーしてズレが累積する(実機で約15回でマス中心→隅まで移動)。
    そのため連続旋回では保持を切らないこと。最後だけ hold=False で停止する。
    """
    link.send(f"TURN,{turn_rad:.5f}")
    time.sleep(settle_s + abs(turn_rad) / 3.0)  # おおまかな旋回時間ぶん余裕
    if not hold:
        link.stop()  # MOT,0,0 で TURN の継続角度保持を止める
        time.sleep(0.15)


def align_heading(link, pose: PoseEstimate, *, settle_s: float = 0.6) -> None:
    """推定ヨー角ぶんだけ TURN で真っ直ぐへ回し、SANG,0 で基準化する(単発)。

    pose.yaw_deg は「正=機体が壁への正対から左(CCW)を向いている」ので、
    正対へ戻すには -yaw 回す。TURN は完了通知を返さないので時間で待つ。
    """
    _turn_by(link, -math.radians(pose.yaw_deg), settle_s=settle_s, hold=True)
    # SANG は place_controller の TURN 保持中に出すと turn_goal と角度フレームが
    # ずれて機体が暴走する。必ず stop() で保持を抜けてから発行する。
    link.stop()
    link.send("SANG,0")
    link.wait_for("DONE", timeout_s=1.0)


def align_to_wall(
    link,
    cam: "OnboardCamera",
    *,
    iterations: int = 3,
    deadband_deg: float = 1.0,
    max_step_deg: float = 20.0,
    set_reference: bool = True,
    slope_gain: float = SLOPE_DEG_PER_YAW_DEG,
    straight_slope: float = STRAIGHT_SLOPE_DEG,
    stop_at_end: bool = True,
    check_dist: bool = True,
    crop_frac: float = 0.5,
    detector=detect_red_band_top_edge,
) -> Optional[PoseEstimate]:
    """前壁に正対するまでカメラ推定→TURN補正を反復する閉ループ(2026-08-03)。

    毎回撮影して estimate_pose し、is_confident でなければ補正を諦める
    (別の壁を掴んだ不良フィット等)。|yaw|<deadband_deg なら整定とみなし終了。
    それ以外は -yaw(max_step_degでクランプ)だけ TURN で回す。最後に
    set_reference なら SANG,0 で「正対=角度0」を走行の基準に定める。

    slope_gain/straight_slope は壁距離に応じた較正定数(既定=約1セル、
    センタリングの半セル壁には *_HALFCELL を渡す)。旋回間は保持を切らず
    (drift累積防止)、stop_at_end=True のとき最後に一度だけ停止する。
    連続してさらに旋回する呼び出し側では stop_at_end=False にして保持継続。

    戻り値は最後の推定値(ログ用)。1回で約9°→1°、数回でサブ度まで収束
    (実機確認、2026-08-03)。距離が較正と違うと gain がずれる点、機体の
    向きによって中央クロップに隣の壁が混入して detection が壊れ
    is_confident に弾かれる点が既知の限界。
    """
    last: Optional[PoseEstimate] = None
    for _ in range(iterations):
        est = estimate_pose(
            cam.capture(), slope_gain=slope_gain, straight_slope=straight_slope,
            crop_frac=crop_frac, detector=detector,
        )
        last = est
        if est is None or not is_confident(est, check_dist=check_dist):
            break  # 信頼できない推定では補正しない(安全側)
        if abs(est.yaw_deg) <= deadband_deg:
            break  # 整定
        step_deg = max(-max_step_deg, min(max_step_deg, est.yaw_deg))
        _turn_by(link, -math.radians(step_deg), hold=True)  # 保持継続=drift防止
    # SANG/停止の順序に注意: SANG は TURN 保持中に出すと turn_goal と角度フレームが
    # ずれて暴走するため、必ず stop() で保持を抜けてから SANG を発行する。
    if set_reference:
        link.stop()
        link.send("SANG,0")
        link.wait_for("DONE", timeout_s=1.0)
    elif stop_at_end:
        link.stop()
    return last
