elkel53930/daylight/software/camera/camera_test.py

#!/usr/bin/env python3
"""
camera_test.py — CSIカメラで vision アルゴリズムを OLED (96x64) 上で検証する。

default_app のメニュー(Applications → Camera Test)からも起動できる。

操作:
    右ボタン: 終了
    左ボタン: 表示モードを切り替え(下記4種を巡回)

表示モード:
    0 MASK  : HSV による黄色マスク後の画像
    1 RATIO : 黄色領域の割合(%)を撮影画像に重ねて表示
    2 WALL  : wall.py で検出した壁上面(赤)下端エッジを線分で重ねる
    3 BALL  : ball.py で検出したボールを円で重ねる

カメラは 320x240 で撮影して各アルゴリズムを実行し、結果を 96x64 に縮小して
OLED に表示する。ui_server が起動している必要がある(手動実行時のソケット
パスは camera/README.md 参照)。

実行中はアームサーボ(Futaba, software/arm/futaba_servo.py)を論理角度0度
(前方固定)に保持する。サーボを動かすとカメラの向きが変わるため
(走行時のカメラ補正と同方針)。サーボが無い環境では警告のみで続行する。
"""

import argparse
import sys
import time
from pathlib import Path

import numpy as np
from picamera2 import Picamera2
from PIL import Image, ImageDraw

sys.path.insert(0, str(Path(__file__).parent.parent / "ui"))
sys.path.insert(0, str(Path(__file__).parent.parent / "vision"))
sys.path.insert(0, str(Path(__file__).parent.parent / "arm"))

from ui_client import UIClient

from ball import detect_yellow_ball, estimate_yellow_ball
from color import make_mask, yellow_ratio
from vision_types import (
    DEFAULT_RED,
    DEFAULT_YELLOW,
    BallEstimationConfig,
    WallEdgeDetectionConfig,
)
from wall import detect_nearest_red_wall_edge

CAPTURE_WIDTH = 320
CAPTURE_HEIGHT = 240
DISPLAY_WIDTH = 96
DISPLAY_HEIGHT = 64

DETECT_THRESHOLD = 0.003  # ボール存在判定の黄色割合(実機で要調整)
WALL_CFG = WallEdgeDetectionConfig(seed=0)

MODE_MASK, MODE_RATIO, MODE_WALL, MODE_BALL = range(4)
MODE_LABELS = {MODE_MASK: "MASK", MODE_RATIO: "RATIO", MODE_WALL: "WALL", MODE_BALL: "BALL"}
NUM_MODES = 4


def capture_bgr(cam: Picamera2) -> np.ndarray:
    """1フレーム撮影して BGR 配列(H,W,3)を返す。

    format=RGB888 の capture_array は numpy 上では BGR 並び(camera_test 旧版・
    vision_algorithm.md の入力仕様と同じ)。
    """
    return cam.capture_array("main")
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
