elkel53930/daylight/(commit log)

2026-05-14 Initial design of main board.
    [encoder_board_drawing.dxf, encoder_board_outline.dxf, main_board.kicad_pcb, main_board.kicad_sch, main_board_drawing.dxf, main_board_outline.dxf, power.kicad_sch, usb_serial.kicad_sch]
2026-05-14 Remove unused file
    [usb_serial.kicad_sch]
2026-06-06 アートワーク完了
    [main_board.kicad_pcb]
2026-06-27 再設計 部品配置完了
    [main_board.kicad_pcb, main_board.kicad_sch, main_board_drawing.dxf, main_board_outline.dxf, power.kicad_sch]
2026-06-28 配線作業中
    [encoder_board_outline.dxf, if_board_drawing.dxf, if_board_outline.dxf, main_board.kicad_pcb, main_board.kicad_sch, power.kicad_sch, rpi_board.kicad_pcb, rpi_board.kicad_sch]
2026-06-29 アートワーク完了、発注
    [main_board.kicad_pcb, rpi_board.kicad_pcb, rpi_board.kicad_sch, rpi_board_drawing.dxf, rpi_board_outline.dxf, sub_boards.kicad_pcb, sub_boards.kicad_sch]
2026-07-13 Beacon実装
2026-07-14 ui: implement UI server with OLED, buttons, and buzzer support
    - ui_server.py: DisplayManager, ButtonManager, BuzzerManager, ClientManager, UIServer
    - SSD1331 96x64 OLED via luma.oled over SPI
    - Tact switches on GPIO19 (LEFT) / GPIO26 (RIGHT) with debounce and long-press
    - PWM buzzer on GPIO13 via lgpio tx_pwm
    - Unix Domain Socket (/tmp/ui_server.sock) with priority-based preemption
    - Length-prefixed MessagePack framing
    - ui_client.py: UIClient with connect/disconnect/display/clear/play/get_buttons API
    - ui_server.service: systemd service with Restart=always
    - examples/: display_image.py, button_test.py, melody_test.py
    - tests/test_protocol.py: protocol and integration tests (hardw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
    [buzzer.rs, test_protocol.py, ui_client.py, ui_server.py]
2026-07-14 fix: swap BGR→RGB channel order for picamera2 output
    [camera_test.py]
2026-07-14 feat: default to video streaming mode, add --once flag for single frame
2026-07-14 feat: add mob firmware (ESP32-S3 hardware drivers)
2026-07-16 画像を撮影してDiscordに投稿するスクリプト
2026-07-16 mob: MCPWMモーター制御、LEDドライバ追加、シリアル受信改善、Makefile最適化
    - motor: ledc -> MCPWM (driver/mcpwm_prelude.h) に移行
    - タイマー40MHz/1024ticks (~39kHz)、速度範囲-1023〜+1023を維持
    - led: GPIO20(緑)/GPIO3(赤)のLEDドライバ追加 (led.h/led.cpp)
    - シリアル受信1バイトごとに赤緑交互点滅
    - mob.ino: Serial.readStringUntilのタイムアウト問題を修正
    - 1文字ずつバッファに積みエンター待ちに変更
    - Makefile: --build-path .build で差分ビルドを有効化
    [led.cpp, led.h, mob.ino, motor.cpp, motor.h]
2026-07-16 mob: ファン・サーボ・ボールセンサ追加、README更新
    - fan: IO2 NchFET ゲート駆動、LEDC 10kHz 8bit PWM (fan.h/cpp)
    - servo: IO1 MG90S RC サーボ、MCPWM group1 50Hz 500-2500us (servo.h/cpp)
    - ball_sensor: IO14 光反射式ボールセンサ、12bit ADC しきい値判定 (ball_sensor.h/cpp)
    - mob.ino: FAN/SRV/BALL コマンド追加、SEN に ball_raw/ball_det フィールド追加
    - README: 全ハードウェア・コマンド・ファイル構成を最新化
2026-07-16 mob: robosweep_twilight の制御コードを daylight に移植 (FWD/STOP/TURN/LATCH/JOG/QSTP等)
    - sensors.h/cpp: LF/RF\u3092前壁F\u306b\u7d71\u5408\u3001ADC\u3092削除(内蔵ADC利用)
    - T\u3092ベースにD向けに適応(wall_sensor/battery参照に変更)
    - motion_controller.h/cpp: T\u304b\u3089そのまま移植
    - Motor\u30a4\u30f3\u30bf\u30d5\u30a7\u30fc\u30b9互換性維持(D\u306eMCPWM 0-1023\u8a2d定)
    - mob.ino: T\u304b\u3089完全に移植\u3001D\u30cf\u30fc\u30c9\u30a6\u30a7\u30a2適応
    - マルチコア処理(Core0/Core1)\u7d71合\u306e移植完了
    - FWD/STOP/TURN/LATCH/JOG/QSTP\u5168コマンド実装
    - SEN\u30ec\u30b9\u30dd\u30f3\u30b9: LF/RF\u3092前壁F\u3067\u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
2026-07-16 mob: robosweep_twilight移植時の命名ミスマッチを修正、解析・レビュー資料を追加
    - LED→Led, get_shared_spi→get_imu_spi, init_shared_spi→init_imu_spi の
    呼び出し名をDaylight側ドライバの実際の定義に合わせ、コンパイル不能を解消
    - コメントアウトされたままだった赤色LEDのFWD開始/完了/起動時の点灯・消灯を
    Twilight本家と同じ挙動に復元
    - mob.inoの詳細解析とコードレビューをmarkdownにまとめて追加
    [mob.ino]
2026-07-16 mob: 旋回制御の内部状態バグとQSTP補正の握りつぶしを修正
    - MotionController::turn_in_place(): 呼び出し元が捨てている戻り値のために
    残っていた内部完了判定を削除。旋回中に残り角度が半分になるたびPID/モーター
    出力を誤って0にリセットしていた問題と、旋回が中断されると内部状態が
    古いまま次の旋回に持ち越される問題を解消
    - updateQstp(): 角度・角速度・壁センサ補正から計算したvr/vlを平均して
    motion.forward()に渡していたため補正が握りつぶされていたのを修正し、
    FWD/STOPと同様に実際の走行に反映されるよ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
    [mob.ino, motion_controller.cpp, motion_controller.h]
2026-07-17 LRボタンが入違っていたのを修正
2026-07-17 default_app: Default UI(ホーム画面)アプリケーションを実装
    ui_server にpriority=100で接続し、システム状態表示・アプリランチャー・
    再起動/シャットダウンを提供する常駐アプリ。PREEMPTEDを正常系として扱い
    自動再接続する。CPU周波数取得はsudo経由に、シグナルハンドラは
    ブロッキング呼び出しを即座に中断できるよう例外を送出する方式にした
    (実機での動作確認で判明した問題への対応)。テスト63件を含む。
2026-07-17 service: 実機登録で判明したsystemdユニットの不整合を修正
    RuntimeDirectoryで作成した/run/ui_serverではなく/run直下にソケットを
    bindしようとして権限エラーになる問題と、lgpioがカレントディレクトリに
    書き込み不可な通知用パイプファイルを作ろうとして起動失敗する問題を
    修正。ui_server/default-ui両サービスをこのラズパイ上で実際に登録・
    起動して動作確認済み。
2026-07-17 default_app: メニュー操作時にブザーで短いクリック音を鳴らす
    L(次へ)/R(決定)のボタン押下エッジでui_client.play()を呼び、
    それぞれ異なる音程の短いクリック音を再生する。
2026-07-17 default_app: アプリ起動時に通知音を鳴らす
    UIを子プロセスへ引き渡す(disconnectする)直前に短いメロディを再生する。
    ui_serverのブザーは接続とは独立したスレッドで鳴り続けるため、
    disconnect後も最後まで再生される。
2026-07-17 default_app: メロディ定義をmelodies.pyに集約
    ボタンクリック音・アプリ起動音・低電圧警告音がdefault_ui.py内に散在
    していたのを、melodies.py一箇所にまとめた。音を変えたいときに探し
    回らなくて済む。不正な音符文字(ui_serverでは休符扱いになり無音化する)
    を検出するテストも追加。
2026-07-17 ui: メロディ試聴スクリプトを追加、再接続不能バグを修正
    try_melody.py: 引数で渡したメロディをui_server経由で再生するだけの
    簡単なスクリプト。software/ui直下に配置。
    実機でtry_melody.pyを使ってdefault-ui.serviceをpreemptしたところ、
    再接続不能になるバグが発覚したため修正した。ui_clientは明示的な
    PREEMPTED応答を受けたときだけ内部ソケットをクリアするが、broken pipe
    などの生の切断エラーではソケットが残ったままになり、次のconnect()が
    「Already connected」で永久に失敗し続けていた。ConnectionError捕捉時に
    必ずdisconnect()を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
    [try_melody.py]
2026-07-17 ui: try_melody.pyの接続失敗時にソケットパスのヒントを表示
    ui_server.serviceはUI_SOCKET_PATH=/run/ui_server/ui_server.sockで
    動いているため、デフォルトの/tmp/ui_server.sockに接続しようとすると
    失敗する。実際に実機で踏んだため、エラー時にヒントを出すようにした。
2026-07-17 default_app: バッテリー電圧に応じてメイン画面の背景色を変更
2026-07-17 default_app: バッテリー低下・CPU高温をDiscordに通知する機能を追加
    ui_serverから切断中(アプリ起動待ち等)も動作するよう独立スレッドで監視する。
2026-07-17 software: ラズパイ側コードの重複整理とディレクトリ構成の見直し
    - ui/: send_msg/recv_msg/定数の三重定義をprotocol.pyに集約、requirements.txt追加、
    ButtonManagerのGPIO番号docstring誤記(左右逆)を修正
    - default_app/: BatteryMonitor/DiscordAlertMonitorのスレッド起動停止コードを
    PollingThread基底クラスに、ヒステリシス判定をHysteresisクラスにそれぞれ集約。
    renderer.pyの黄色背景閾値をbattery.pyの定数から参照するよう統一
    - camera_discord.py/camera_test.pyをsoftware/camera/へ移動し、他機能ディレクトリ
    (beacon/, default_app/, ui/)と構成を揃えた
    ESP32(mob/)側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
    [camera_discord.py, camera_test.py, protocol.py]
2026-07-17 software: venv戦略を明文化(ui/default_app/cameraは共有、beaconは独立のまま)
    ui/・default_app/・cameraは同じRPi固有ハードウェアライブラリ(lgpio, picamera2,
    luma等)に依存しており個別venvにしても分離効果が薄いため、software/venv
    (--system-site-packages)を共有する方針に統一。ルートのrequirements.txtは
    現行コードで使われていない古い依存(cbor2/colorzero/gpiozero/RPi.GPIO/spidev)
    を含んだまま放置されていたため、実際の依存に合わせて書き直した。
    beaconはハードウェア依存が無いため既存の独立venvのまま変更していない。
    software/README.md を新規追加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
2026-07-17 software: venvドキュメントのコードレビュー指摘を修正
    - software/README.mdのテスト実行コマンドが repo root から実行すると
    ImportError で失敗するパス誤りを修正(default_app/tests → software/default_app/tests)
    - picamera2のapt installをsoftware/README.mdの共有venvセットアップ手順から
    切り離し、camera/を使う場合のみ必要と明記(default_app/ui専用作業では不要)
    - requirements.txtのコメントヘッダーを日本語化・簡潔化し、beacon独立venvの
    方針説明とapt installコマンドの重複記載を削除してsoftware/README.mdに一本化
    - default_app/README.md・ui/README.mdの「/opt/..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
2026-07-17 camera: UI_SOCKET_PATHの指定が必要なことをREADMEに追記
    camera_test.pyを手動実行するとui_client.UIClientのデフォルト接続先
    (/tmp/ui_server.sock)がui_server.service/default-ui.serviceの実際の
    ソケット(/run/ui_server/ui_server.sock)と一致せず接続に失敗する。
    実機での動作確認時に踏んだため、手順として明記した。
2026-07-18 ui: ブザーをBCM2711ハードウェアPWM(PWM0 ch1)駆動に変更
    lgpioのソフトウェアPWMからsysfs(/sys/class/pwm)経由のハードウェアPWMに
    変更。要 dtoverlay=pwm,pin=13,func=4。overlay未設定環境では警告を出して
    従来のソフトウェアPWMにフォールバックする。
    - export直後のEACCESはudev(99-com.rules)の非同期な権限付与待ちとして
    最大2秒リトライ。ここで誤フォールバックするとGPIO13のALT0マックスが
    通常出力に上書きされ、以後ハードウェアPWMの波形がピンに出なくなる
    (実機で発生した無音障害の原因)
    - docstringの誤記修正(GPIO 14 → 13)
    - README: o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
    [ui_server.py]
2026-07-18 CLAUDE.md: リポジトリ開発の前提知見をまとめたプロジェクト指示を追加
    mobシリアルプロトコルの落とし穴、venv・テスト規約、micromouse設計要点など
    2026-07-17のマイクロマウス実装セッションで得た知見を集約。
2026-07-18 CLAUDE.md: 2026-07-18セッションの知見を追記
    - ブザーのハードウェアPWM化とALT0マックス破壊の落とし穴(GPIO13をlgpioで
    claimしない、復旧はpinctrl set 13 a0)
    - 実機のsystemd unitはリポジトリの.serviceと異なる(ui_serverは作業ツリー
    直参照・User=k-iida、反映はrestartのみ)
    - micromouse実装はmicromouse_hw_testブランチにありmaster未マージである旨
    - mobのGEAR_RATIO(41/20)が2ファイルに重複定義されている注意
    - Discord投稿はbeaconのload_webhook_url()を再利用する方針
2026-07-18 mob: エンコーダ直結化に伴いGEAR_RATIOを41/20から1.0に変更
2026-07-18 CLAUDE.md: ギア比の記述をGEAR_RATIO=1.0(直結)に更新
2026-07-23 mob: 吸引ファンをmob.inoに統合、PWM周波数を40kHzに変更
    Fanクラス(fan.h/cpp)はドライバのみ実装済みで未接続だったため、
    mob.inoにインスタンス化・begin()呼び出し・シリアルコマンド
    FAN,<0-255>(0-255、0=停止)を追加した。WALLコマンドと同様、
    Core0の1kHz制御ループを経由せずloop()側で直接処理する。
    あわせてPWM周波数を10kHzから40kHzに変更(実機で動作確認済み)。
2026-07-23 arm: Futabaコマンドサーボ制御スクリプトを追加
    robosweep_twilight(前身機)のarm.pyからFutaba制御部分のみを移植。
    ラズパイのUARTから直接RS204MD/RS304MDへコマンドパケットを送信する
    (Arduino経由のランチャー/モータ制御はDaylightに無いため除外)。
    実機校正でトルクON時の物理停止位置が-130度だったため、
    zero_offset_degで論理角度0を-130度に対応させている。
    直接実行(python futaba_servo.py <angle>)すると指定角度へ2秒かけて
    移動しトルクを抜く。requirements.txtにpyserialを追記。
2026-07-23 mob: RCサーボ(IO1)をmob.inoに統合、Makefileのuploadを修正
    servo.h/cpp(MCPWM group 1、IO1、MG90S)はドライバのみ実装済みで
    未接続だったため、mob.inoにインスタンス化・begin()呼び出し・
    シリアルコマンドSRV,<0-180>(度)を追加した。FAN/WALLコマンドと同様、
    あわせて、Makefileのuploadターゲットに--input-dirが無く、arduino-cli
    のデフォルトキャッシュ(直前のcompileとは無関係な古いバイナリ)が
    書き込まれることがあるバグを修正(turn_angle_controlブランチで
    先に修正済みだった内容と同じ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
    [mob.ino]
2026-07-23 mob: RCサーボのトルクオフ(SRVOFF)コマンドを追加
    PWM制御のRCサーボにはトルクON/OFFレジスタが無いため、
    mcpwm_generator_set_force_level()で出力をLowに強制固定し
    パルス自体を止めることでトルクを抜くdetach()をServoクラスに追加。
    次のset_angle()呼び出しでforceを解除し通常出力に自動復帰する。
    実機書き込み・動作確認済み(SRV,90→SRVOFF→SRV,90)。
2026-07-23 util: RCサーボ操作スクリプトservo_control.pyを追加
    mobのSRV,<angle>/SRVOFFコマンドをシリアルで送信するCLI。
    --angle <0-180>で角度指定、--offでトルクオフ(脱力)。
    実機動作確認済み(--angle 45 → --off → --angle 90)。
2026-07-23 mob: ボールセンサ(IO14)をmob.inoに統合、SENにball_raw/ball_detを追加
    ball_sensor.h/cpp(内蔵ADC、IO14、しきい値判定)はドライバのみ実装済みで
    しきい値設定コマンドBALL,<0-4095>を追加した。SENレスポンスの末尾に
    ball_raw(ADC生値)とball_det(検出フラグ)を追加。
    あわせてREADMEのSENレスポンス形式の記述を実装(lf/ls/rs/rf、
    odo_dist/odo_ang)に合わせて修正(旧記述はwall_r/f/lの3値のみで
    実装と不一致だった)。
    実機書き込み・動作確認済み(SEN応答にball_raw/ball_det追加、
    BALL,1500でし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
    [mob.ino]
2026-07-23 util: ボールセンサ生値表示ツールball_check.pyを追加
    mobのSENコマンドを--interval秒毎(既定0.5秒)に発行し、
    レスポンス末尾のball_raw/ball_detを表示するCLI。
    実機動作確認済み。
2026-07-23 util: READMEを追加
    servo_control.py/ball_check.pyの使い方と共通オプションをまとめた。
2026-07-23 micromouse: マイクロマウス自律走行アプリを新規実装
    足立法探索→ゴール到達→帰還→最短経路計画→最短走行の全シーケンスを実装。
    maze/explorer/path_plannerはハード非依存の純Python、simulatorは実機ドライバと
    同一インターフェースの仮想mob。全日本大会の実迷路2面(1981/1993)を
    シミュレーションで完走、テスト64件パス。実機検証用のhw_test.py付き。
    - 実装指示書(implement_micromouse.md)と実装報告書も収録
    - default_appのapplications.yaml.exampleにMicromouseエントリを追加
    - requirements.txtにpyserialを追記(venvへの導入は未実施)
    - .gitignoreにPyt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
2026-07-23 mob: 前進方向を実機に合わせて反転(モータ極性+エンコーダ符号)
    fwdで機体が後退したため、方向ピンの極性と速度PID・オドメトリの
    エンコーダ符号を3箇所セットで反転。実機fwdで180.5mm/+0.01radを確認。
2026-07-23 mob: STOP最終進入の最低速度を20→40mm/sに引き上げ
    20mm/sでは静止摩擦に負けて目標0.7mm手前でスタックし、
    4秒タイムアウト→30mm後退が発生していた。
2026-07-23 docs: マイクロマウス実機検証(2026-07-18)の進捗と残タスクを記録
2026-07-23 mob: バッテリー電圧をanalogReadMilliVoltsで補正付き読み取りに変更
    3.3Vフルスケール仮定の線形換算はESP32-S3のADC特性と合わず
    約11%低く出ていた(実測8.11Vに対し7.19V)。eFuseの工場
    キャリブレーションを使うanalogReadMilliVolts()に置き換え、
    誤差を約1%に改善(実測9.17Vに対し9.07V)。
2026-07-23 micromouse: ERROR終了時にOLEDへエラー理由を表示
    「DONE ERROR」だけでは原因が分からなかったため、mission.error_message
    を最大2行(32文字)OLEDに表示する。例: "no path to goal from (0, 0)"
    [micromouse_app.py]
2026-07-23 mob: 実機チューニング一式(蛇行・旋回精度・速度ムラの改善)
    2026-07-19 の実機テレメトリ計測に基づく改修:
    - 壁補正の中央目標値をセル中央実測に再校正(LS 233→311 / RS 209→229)。
    旧値との差が1kHzで目標角度に積算され、蛇行の主因だった
    - 壁補正ゲインを 5e-6→2e-6 に減速、角度FB 0.3→0.5、角速度FB 0.01→0.04。
    ヨー振動(ジャイロ±0.6rad/s)を±0.1程度まで抑制
    - TURN: 許容誤差 0.03→0.01rad、整定確認(80ms待ち→再サーボ最大3回)を追加。
    90°旋回の実測誤差 最大1.8°→0.6°。最低速度 0.04→0.06m/s
    - 車輪速度制御をFF+PID化: FF=25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
2026-07-23 docs: マイクロマウス実機検証(2026-07-19)の進捗と残タスクを更新
2026-07-23 docs: 現在の制御アルゴリズムの詳細ドキュメントを追加
2026-07-23 mob: 旋回制御を速度ベースPIDにチューニング、固定パターンテストを追加
    updateTurnをP制御から条件付きPID(残角が小さい最終アプローチでのみ
    I/Dを効かせる)に変更し、TURN_ACCEL_MPS2とTURN_MAX_SPEED_MPSの調整で
    オーバーシュートを7〜24°から数度程度まで低減。左右速度同期は2度試して
    悪化したため無効化のまま。
    software/micromouse/pattern_test.py: 右旋回→左旋回→180度旋回のみを
    実行する固定パターンテストを追加し、default_appのApplicationsメニュー
    からも起動可能にした。mobile_base.MobileBaseにraw_log_fnフックを追加し、
    #Vテレメト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
2026-07-23 mob: 生duty直接指令コマンドDUTYを追加、motor_check.pyでモーター単体診断
    既存のMOT,<r>,<l>は目標速度[mm/s]を速度PIDに渡すもので生dutyでは
    ないため、ギア滑り疑いの診断のように「一定duty比で回した実際の
    挙動」を確認する用途には不向きだった。速度PIDを経由せず直接duty
    (-1023〜+1023)を指令するDUTY,<r>,<l>コマンドを追加し
    (motion_controller.hにMode::DUTY_DIRECTとset_duty_direct()を追加、
    apply_speed_pid()はDUTY_DIRECT中は速度推定のみ行いduty上書きを
    スキップする)、これを使うsoftware/util/motor_check.pyを追加した。
    左右モーターを指定duty比(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
2026-07-23 micromouse: SEN応答のボールセンサ拡張(12フィールド)にparse_sen_lineを追従
    masterでのボールセンサ統合によりmob.inoのSEN応答が10→12フィールドに
    増えていたが、rebase後もwall_detector.pyが旧フィールド数のままで
    全てのSEN行がパース失敗しPattern Testが sensor read failed で落ちていた。
    [wall_detector.py]
2026-07-23 util: motor_check.pyをSEN応答の12フィールド形式に追従
    mob.inoのボールセンサ統合でSEN応答が10→12フィールドに増えていたが、
    motor_check.pyのparse_sen_lineが旧フィールド数のままでSEN応答を
    全て読み捨てていた。
2026-07-23 util: motor_check.pyを10Hzサンプリング+1秒平均のRPM表示に変更
    瞬時値(1秒間隔の差分)は個々のサンプルのノイズが出やすいため、
    0.1秒間隔でサンプリングしたRPMを1秒毎に平均して表示するように変更。
2026-07-23 mob: 旋回の左右速度同期を専用LPF付きで再有効化、並進ドリフト-52mm→±4mm
    過去2回の再有効化失敗は、同期ループが個別車輪PIDと同じ生の速度信号
    (SPEED_LPF_ALPHA=0.12、時定数≈8ms)に反応して結合振動していたことが
    原因と分析。同期誤差専用の緩いLPF(SYNC_ERR_LPF_ALPHA=0.02、時定数
    ≈50ms)を追加して低周波の定常ずれのみに反応させ、車輪PIDと周波数帯を
    分離した上でTURN_SYNC_KP=0.3、TURN_SYNC_KI=1.0で有効化。
    ギア滑り修理後のPattern Test(旋回のみ3ステップ)10回で並進ドリフト
    平均-0.7mm(8/10回が±4mm以内、修正前-52mm)、角度誤差±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
    [motion_controller.cpp, motion_controller.h]
2026-07-23 mob: 直進の角度・角速度FBゲインを下げ数Hzの発振を解消
    補正corr[m/s]は左右輪目標に±corrで振り分けられるため、ヨー系の
    ループゲインは 2*GAIN/WHEEL_BASE(76mm) となる。旧値(ANGLE=1.0、
    RATE=0.3)はレートループゲイン≈7.9で、高速化した車輪速度PID
    (KI=3000)+速度LPF の位相遅れと合わさり発振していた(実機で
    duty±400超、実測車輪速度-118〜995mm/s、機体がガタガタ振動)。
    ANGLE_FB_GAIN 1.0→0.15、ANGULAR_RATE_FB_GAIN 0.3→0.05
    (レートループゲイン≈1.3)に変更。1マス直進で車輪速度の素直な追従・
    duty単調減少・最終角度-0.6°を確認。
    Co-Auth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
2026-07-23 mob: STOP完了後に0.5秒の角度維持ホールドを追加、ANGLE_FB_GAINを0.5に
    停止時にduty=0で即座に制御を切ると慣性で機体が回頭する
    (実機ログ: DONEの17ms後にgz=1.1rad/s、角度+0.7°→+1.7°に変化中)。
    DONE送信後もSTOP_HOLD_SEC(0.5秒)の間はv=0のまま角度FB(目標=STOP開始時
    の角度)+角速度FBを継続し、慣性の回頭を打ち消して向きを保つ。
    次のモーションコマンドが来たら即解除するため走行シーケンスには影響しない。
    ANGLE_FB_GAINは0.15では角度保持が緩く±1.5°ふらついたため段階的に増強
    (0.15→0.3→0.5)。0.5で走行中の角度彷徨いが±0.9°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
2026-07-23 micromouse: pattern_testに開始メロディ+1秒待ちを追加、閉路パターンに変更
    - 走行開始タイミングが分かりにくかったため、ジャイロ校正後にメロディを
    鳴らして1秒置いてから走り出すように変更(--no-uiのコンソールモードでも
    ui_server経由でブザーを鳴らす)
    - 最終オドメトリ読み取り前に0.7秒待つように変更(走行終了直後にMOT,0,0を
    送るとmob側のSTOP後角度維持ホールドが中断されるため。ログ上の最終SENも
    静定後の値になる)
    - 走行パターンを旋回のみ3ステップから、開始位置・開始向きに戻る
    直進+旋回の閉路10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
2026-07-23 mob: STOP/TURN完了時にホールド整定を済ませてからDONEを返すよう変更
    前コミットのDONE後ホールドは、DONE直後に次のコマンドが届く連続走行では
    即座に潰されて機能していなかった。閉路パターン走行のログ分析で、旋回の
    慣性で回転中の角度を次のSTRAIGHTが基準角として取り込み、旋回直後の
    直進だけ基準角が2〜5°汚染されることを確認。
    - ホールド(0.5秒、v=0+角度・角速度FB)をDONE送信の前に移動し、
    DONEの意味を「動作完了かつ整定済み」に変更(呼び出し側は変更不要)
    - TURN完了時にもホールドを追加(目標=turn_goal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
2026-07-24 mob: 壁センサFBを比例方式に刷新して有効化、STOP時にも適用
    無効化されていた壁センサ横位置補正を再設計して有効化。
    - 基準値をセル中央で再計測(n=20): TARGET_LS 311→348、TARGET_RS 229→241
    - 旧実装の「誤差を毎ms目標角に積算」は減衰項のない二重積分ループで、
    ゲインをいくら下げても中央を行き過ぎる(実機: 左25mmずれ→右15mm
    オーバーシュート、半減しても改善せず)。誤差に比例した傾きを目標角に
    直接与える方式(WALL_TILT_RAD_PER_UNIT=0.0015、±7°クランプ)に変更し、
    横速度∝-横位置の一次系として指数収束さ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
2026-07-24 CLAUDE.md: マージ・チューニング完了を反映し古い記述を更新
    - SEN応答を12フィールド(ボールセンサ拡張)に更新
    - STOP/TURNのDONEが「整定済み」を意味するようになった点と、
    書き込み直後の初回シリアル接続の取りこぼしを追記
    - micromouse実装のmaster未マージ記述を削除し、走行チューニングの
    到達点(2026-07-24)を記載
2026-07-24 mob: リモートビルドサーバー(x13u)へのオフロード機能を追加
    remote_build.md の設計提案に沿って実装。BUILD_HOST が設定・到達可能な
    ら Linux ビルドサーバーで arduino-cli compile を実行し、成果物だけを
    rsync で持ち帰る。未設定・到達不可・リモート側のビルド失敗（コマンド
    未導入等）の場合は自動的にローカルビルドへフォールバックする。
    - Makefile: build を scripts/arduino-build.sh 経由に変更。upload は
    build に依存する形に統一(従来はcompileを重複実行していた)
    - ホスト名・ユーザー名(k-iida@x13u.local)はリポジトリに含めない。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
2026-07-24 mob: 機体固有チューニングパラメータをシリアル経由で変更・NVS永続化
    ロボットを4機程度製作予定で、旋回PID・壁センサ基準値など約37個の
    チューニング定数がハードコーディングされていると個体差管理が難しく、
    調整のたびにビルドし直すコストも大きい。params.h/params.cppに全定数を
    Params構造体としてまとめ、シリアルコマンドで変更・機体ごとに恒久保存
    できるようにした。
    - PGET[,<name>] / PSET,<name>,<value> / PSAVE / PLOAD / PRESET
    - PSAVEはパラメータ名ごとに個別のNVSキーで保存(Preferencesライブラリ)。
    そのためParamsに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
2026-07-24 util: パラメータ調整用TUIツール(param_tui.py)を追加
    software/mob/params.hのPGET/PSET/PSAVE/PLOAD/PRESETをcursesのTUIで
    操作できるようにした。パラメータ一覧はハードコードせず起動時にPGETで
    mobから取得するため、ファームウェア側でparams.hにパラメータを追加/
    削除してもツール側の修正は不要。SEN値(バッテリー電圧・壁センサ・
    エンコーダ・オドメトリ・ボールセンサ)を約5Hzで上部に表示し続ける。
    実機(tmux経由)で以下を確認:
    - 起動時のPGET一覧取得・SEN表示
    - ↑↓選択、←→でのPSET即時反映(値・SEN欄とも表示更新を確認)
    - [/]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
    [param_tui.py]
2026-07-24 micromouse: pattern_testを2x4マスの閉路パターンに戻す
    param_tui.py動作確認のため一時的に壁センサFB確認用の3マス直進のみに
    していたが、mob-paramsマージ前の最終走行確認用に元の閉路パターン
    (1直進→右→1直進→左→2直進→左→1直進→左→3直進→180度旋回)に戻す。
2026-07-24 micromouse: カメラによるジャイロ角度ドリフト補正(壁上面赤帯検出)を実装
    壁上面の赤帯上端エッジを検出しヨー角のズレを推定するvision.py、mob側の
    絶対角度上書きコマンドSANG、実機検証用のhw_test.pyサブコマンド
    (camera-capture/camera-sweep/camera-correct/camera-straighten)を追加。
    実機でTURNによる物理補正まで確認済み(較正式は暫定、TODO.md参照)。
    [hw_test.py, mob.ino, mobile_base.py, sensors.cpp, sensors.h, vision.py]
2026-07-24 mob/micromouse: 排他モーションフラグをenumに統一、JOGTURN追加、距離補正対応
    mob.inoの fwd_active/stop_active/turn_active 等8個の個別boolフラグは
    常に排他だったが、新モーション開始時に他フラグを手動でリセットする
    実装だったため書き漏れ(CMD_LATCH_STARTがjog_activeを未リセット等)が
    起きやすかった。単一のMotionState enumに統一し、構造的に排除した。
    これに合わせてJOGTURNコマンド(低速固定速度での目標角旋回)を追加し、
    camera-straightenの角度・距離補正をJOGTURN/JOGFWD/JOGBACKベースに変更
    (180度旋回2回で後退する旧トリックが新た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
2026-07-24 arm: FutabaServoの破棄時にトルクを自動で切るようにする
    close()(with文終了・__del__経由のガベージコレクション時も含む)で
    set_torque(False)してからシリアルを閉じるようにし、使い終わった後に
    サーボが脱力せず力んだままになる状態を防ぐ。
2026-07-24 micromouse: 探索走行にカメラによる位置補正を統合
    探索の判断点(前壁があり静止するタイミング)で、前回補正から一定セル数
    (既定10)経過していたら、カメラで壁上面の赤帯を検出してヨー角・前進距離を
    補正し、ジャイロも再キャリブレーションする。前方固定カメラのため補正できる
    のは現在向いている軸のみだが、探索中に機体は全方位を向くため結果的に
    X軸・Y軸どちらも補正される。
    - camera_correction.py(新規): hw_test.pyに散在していた較正定数・推定ロジック
    を集約し、信頼度ゲート(is_confident、較正範囲外の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
2026-07-24 micromouse: default_appメニューへの登録とスタート/ゴールメロディ変更
    - default_app のメニューから Micromouse を起動できるよう
    /etc/robot-ui/applications.yaml に登録(実機は反映済み。default_ui.py が
    メニュー選択のたびに読み直すためサービス再起動不要)。リポジトリ側の
    applications.yaml.example とCLAUDE.mdを実態(作業ツリー直接参照の
    パス規約)に合わせて更新。
    - スタートメロディを「スタート前」(Rボタン押下直後・キャリブレーション中で
    機体が静止しているタイミング)に鳴らすよう変更。
    - ゴール到達時(GOAL_REACHED)に指定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
2026-07-25 arm: ボール回収シーケンススクリプトを追加
    リロードサーボ(mob SRV)・アームサーボ(Futaba)・吸引ファン(mob FAN)・
    ボールセンサ(SEN ball_raw)を連携させ、ボール回収の一連動作を実行する
    software/arm/ball_sequence.py を追加。
2026-07-25 vision: カメラによる黄ボール・赤壁エッジ検出を追加
    vision_algorithm.md に沿って software/vision/ を新設。
    - color.py: cv2 で BGR→HSV・HSVマスク・モルフォロジー
    - ball.py: 黄ボールの高速存在検出と RANSAC 円フィット(最大輪郭入力、
    信頼度=インライア率)
    - wall.py: 赤壁上面の下端エッジ検出(最も手前を選択し y=ax+b で返す)
    - vision_http_test.py: 撮影+検出結果オーバーレイを HTTP 配信する実機確認用
    - tests: 人工画像による単体テスト27件
    HSV既定値・モルフォロジー・最大輪郭選択は robosweep_twilight の
    camera_py/ball_detect.py を参考にした。c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
2026-07-25 camera: camera_test.pyをvisionアルゴリズム検証ツールに刷新
    - 右ボタンで終了、左ボタンで表示モード切替(MASK/RATIO/WALL/BALL)
    - 320x240で撮影し検出、結果を96x64に縮小してOLEDに重畳表示
    - 実行中はアームサーボ(Futaba)を0度固定(カメラ前方固定)
    - color.pyに yellow_ratio / color_ratio(黄色領域割合)を追加
    - default_appメニューにCamera Testを登録(applications.yaml.example更新、
    実機の/etc/robot-ui/applications.yamlにも追記済み)
2026-07-25 manual_controller: DualSenseによる遠隔操作を追加、default_appメニューに登録
    zeroconfで機体を検索し、TCP経由でPC(Ubuntu)のゲームコントローラ入力を
    機体(ラズパイ)へ送る遠隔操作機能を追加。
    - protocol.py: 通信メッセージ形式・zeroconfサービス定義(依存無し)
    - remote_controller.py: ボタン→機体動作の変換ロジック本体(ハード非依存)
    十字キー上=1区間前進を繰り返す、右/左/下=90/90/180度旋回(1回)、
    △○×▢=低速前進/右旋回/後退/左旋回(mobのLATCH系コマンドを使用)
    - remote_server.py: 機体側実行スクリプト。zeroconf広告+TCPサーバー。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
2026-07-25 manual_controller: DualSenseの△▢ボタン割り当てを実機に合わせて修正
    実機のDualSenseでは event.button の2番=△, 3番=▢だった(想定は2=▢,
    3=△で逆)。低速前進(△)と低速左旋回(▢)が入れ替わっていたため、
    input_mapping.py と参考元の dualsense_test.py の両方を実測値に修正。
2026-07-25 default_app: Applicationsメニューが画面外に出る問題を修正、スクロール対応
    render_menu() は常に先頭から描画していたため、項目数が増えて画面に
    収まらなくなると選択が画面外の項目に進んでも表示が変わらず操作不能に
    見えていた。選択中の項目が常に可視範囲に入るようスクロールし、画面外に
    項目がある場合は上下に ^/v インジケータを表示するようにした。
2026-07-25 manual_controller: OLED表示が出ない不具合を修正(protocol.py名衝突)
    Manual Control をメニューから起動しても OLED の表示が変わらない不具合を
    実機ログ(journalctl)で調査したところ、software/manual_controller/
    protocol.py と software/ui/protocol.py が同じモジュール名だったため、
    先に import した manual_controller 側が sys.modules にキャッシュされ、
    ui_client.py の `from protocol import SOCKET_PATH` が意図しない方の
    protocol.py を掴んで ImportError になり、ui_loop() が「OLED表示は無効」
    として静かにスキップしていたことが判明(標準出力はメニュー起動時には
    見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
2026-07-25 manual_controller: 旋回入力を単一変数からFIFOキューに変更
    stop_at()/turn() は mob の DONE 応答(STOP/TURNは完了後0.5秒の角度
    維持ホールドを経てから返る)を待つブロッキング呼び出しのため、前の
    動作の完了待ち中に十字キー左/右/下を複数回押すと、単一変数
    (_pending_turn_rad)では最後の1回しか残らず取りこぼしていた。
    FIFOキュー化し、押した順に全て実行されるようにした。
    体感レイテンシ(場合によっては1秒以上)自体の主因はmob側のSTOP/TURN
    完了待ち(0.9秒程度の動作時間+0.5秒ホールド)であり、これは慣性回転中の
    角度誤取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
2026-07-25 mob: JOGFWD/JOGBACK/JOGTURNにIMU(ジャイロ)フィードバックを追加
    JOGFWD/JOGBACK は左右輪に同じ目標速度を与えるだけの完全オープンループ
    で、走行中の進行方向ドリフトを一切補正していなかった。FWD/STOPと同じ
    角度+角速度FB(angle_fb_gain/rate_fb_gain、壁センサ補正は無し)で直進を
    保持するようにした。開始時角度を jog_target_angle_rad に保存し基準とする。
    JOGTURN は目標角度到達後、即座に停止してDONEを返しており、STOP/TURNと
    違って慣性の減衰待ちが無かった。STOP/TURNと同じSTOP_HOLD状態に遷移させ、
    角度+角速度FBで整定させてか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
2026-07-25 manual_controller: L1にボール回収シーケンス、R1にリロード解放を実装
    L1押下でball_pickup.pyのボール回収シーケンスを実行:
    1. アーム・リロードサーボを0度へ
    2. 0.5秒待つ
    3. リロードサーボを140度へ
    4. アームサーボを1000msで103度へ
    5. アームサーボ到達(1000ms後)でファンDuty 50%
    6. ball_rawが100を3回連続で超えたらアームサーボを1000msで0度へ。
    2秒以内に検出できなければリロードサーボを0度に戻して失敗終了
    7. アームサーボ到達(1000ms後)でファンDuty 0%
    8/9. 最終確認でball_raw<100ならリロードサーボを0度へ(失敗)、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
2026-07-26 manual_controller: OLED文字の重なりと終了処理のバグを修正
    接続状態の表示文字列に改行を含めていたため、draw.text() が1行分の
    枠のつもりで呼んだ描画が実際には2行分描画してしまい、下のBALL/
    L: Quit行と重なって読めなくなっていた。1行に収まる表示に修正。
    終了処理(main()のfinally)で ball_pickup.py の定数(FAN_OFF_PERCENT等)を
    未importのまま参照しており NameError で必ず落ちるバグ、および
    base.close()/arm.close() より後に書き込もうとしていたバグを修正。
    ball_pickup.py から定数を import し、ファンOFF・リロード/アームを
    0度へ戻す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
    [ball_sequence.py]
2026-07-26 manual_controller: 壁センサLEDを有効化、arm未接続時のNone参照を修正
    1区間前進(stop_at→mobのSTOP)は壁センサFB(lateral correction)の
    コードパス自体はmicromouseと共通で持っているが、壁センサLED(WALL,1)を
    一度も有効化していなかったため、センサ差分値が常にしきい値未満(無効)
    判定になり実質的に無効化されていた。起動時にwall_led(True)、終了時に
    wall_led(False)を呼ぶようにした(hw_test.py/pattern_test.py/
    state_machine.pyと同じパターン)。
    あわせて、arm(Futabaサーボ)が未接続(make_arm_servo()がNoneを返す)の
    場合に arm.set_angle() を無条件で呼ん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
2026-07-26 manual_controller: 1コマンド完了時にコントローラを振動させる
    十字キー上(1区間前進)・左/右/下(90/180度旋回)が成功完了するたびに、
    機体からPCへ振動通知を送りDualSenseを0.1秒振動させる。JOG系(△○×▢、
    押しっぱなし)・L1・R1では送らない。失敗(リンク切断等)時も送らない。
    - remote_protocol.py: rumbleメッセージ型(robot→PC方向)を追加
    - remote_controller.py: on_command_done コールバックを追加。stop_at()/
    turn() が例外無く完了したときのみ呼ぶ(_safe_callの戻り値で判定)
    - remote_server.py: queue.Queue でコールバックから handle_client() の
    送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
2026-07-26 manual_controller: STOP/TURN整定ホールドを手動操作中だけ一時短縮
    前進・旋回のたびにSTOP/TURN完了後0.5秒の角度整定ホールド(mobの
    params.stop_hold_sec)を待つ必要があり、手動操作では体感レイテンシの
    主因になっていた。ファームウェアのDONEタイミング自体は変更せず
    (慣性角度誤取り込み防止のため変更禁止、CLAUDE.md参照)、ランタイム
    PSET可能なパラメータであることを利用し、remote_server.py起動時に
    0.5秒→0.05秒へ一時短縮、終了時に元の値へ復元するようにした。
    - MobileBase.get_param()/set_param() を追加(PGET,<name>/PSET,<name>,<value>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
2026-07-26 manual_controller: 操作中のカメラ映像をHTTPで配信
    リモート操作中にPCのブラウザで機体カメラの映像を確認できるよう、
    camera_stream.py(Picamera2 + 標準ライブラリhttp.server)を追加し、
    remote_server.py起動時に自動で立ち上げるようにした(既定ポート8080、
    --no-cameraで無効化可)。
    software/vision/vision_http_test.pyと同じ仕組み(短間隔JPEGポーリングに
    よる疑似ライブ映像)だが、検出オーバーレイ処理が無い分さらに高速
    (実機で1フレームあたり40-113ms、検出処理ありの5.5fpsより高速)。
    カメラに接続できない場合は警告のみで操作自体には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
2026-07-26 util: param_tui.pyで壁センサLEDを有効化(SEN表示が常に0だった不具合)
    壁センサはLED ON/OFF差分方式のため、WALL,1で有効化しないとlf/ls/rs/rf
    が常に0のままになる。param_tui.pyはSEN値を常時表示するが、この
    有効化を一度もしていなかった。起動時にWALL,1、終了時にWALL,0を送る
    ようにした(hw_test.py等の既存パターンと同じ)。
    実機で確認: 有効化前は lf=ls=rs=rf=0、有効化後は実際の差分値
    (lf=260 ls=40 rs=144 rf=260 等)が取得できることを確認済み。
2026-07-26 manual_controller: 1マス前進の前に距離をリセットし常に正確な距離にする
    mobのSTOPコマンドは指令距離を累積目標(cumulative_goal_dist_mm)に
    加算する方式で、JOGFWD/JOGBACK(△×)はこの累積値を更新しない。その
    ため直前にJOGで動いていたり、過去のSTOP/FWDの実移動量が指令値から
    わずかにずれていたりすると、そのズレを引きずったまま「180mm前進」の
    つもりが違う距離になっていた。
    十字キー上(1区間前進)を実行する直前に毎回 reset_distance()(RDST、
    mob側でcumulative_goal_dist_mmも同時にリセットされる)を呼ぶようにし、
    常に現在位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
2026-07-26 camera: 最大解像度・画角でのカメラ性能検証スクリプトを追加
    Camera Module 3 Wide(imx708_wide)は4608x2592/2304x1296がフル画角、
    1536x864のみクロップされ画角が狭くなる点をsensor_modesで確認して反映。
    1秒間隔でHTTP配信し、撮影・エンコード時間を計測する。
2026-07-31 新しいエンコーダ基板の外形部品配置図
    [encoder_board_drawing.dxf, encoder_board_outline.dxf]
2026-07-31 新エンコーダ基板のアートワーク作業中
    [encoder_board_drawing.dxf, sub_boards.kicad_pcb, sub_boards.kicad_sch]
2026-08-01 新しいエンコーダ基板のアートワーク官僚
    [sub_boards.kicad_pcb, sub_boards.kicad_sch]
2026-08-02 製造のために左右のエンコーダを一つの基板にまとめた
    [sub_boards.kicad_pcb]
2026-08-02 mob: ESP32制御ロジックを刷新、その場静止制御(HOLD)を追加
    移動系コマンド(FWD/STOP/TURN/JOGFWD/JOGBACK/JOGTURN/LFWD/LBACK/
    LTURNL/LTURNR/LSTOP/QSTP)と、それに依存するsoftware/micromouse/・
    software/manual_controller/を削除し、制御ロジックを根本から作り直す。
    モータードライバ・IMU・エンコーダ等の低レベル層はそのまま。
    第一歩として、左右輪速度の和(並進成分)をエンコーダFBでゼロへ追い込む
    その場静止制御を追加(HOLDコマンド、place_controller.cpp)。実機で
    speed_kp/kiの4倍(kp=1200, ki=12000)まで上げても発散せず安定することを
    確認し、デフォ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
2026-08-02 mob: その場旋回(TURN、角加速度一定の台形プロファイル)を追加
    place_controller.cppを拡張し、start_turn()でその場旋回に対応。目標角度を
    角加速度一定の台形速度プロファイルで滑らかに変化させ、角度+角速度FBで
    追従する。並進ゼロを保つHOLDの制御を旋回中も同時に動かし続けることで、
    旋回によって機体の位置がずれるのを防ぐ設計。
    速度推定を1msごとの生エンコーダ差分から10ms窓平均に変更(量子化ノイズが
    支配的でHOLDのvsumが±15〜20mm/sで頭打ちだった問題を解消、±2mm/s程度まで改善)。
    実機チューニング: 角度追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
2026-08-02 mob: HOLDに位置ホールドとIMU加速度FFを追加
    速度(左右輪速度の和)の平均をゼロにするだけでは位置の復元力が無く
    ドリフトしうるため、外側に位置ループ(sensors.get_distance()を開始時の
    値に保つP制御→目標速度→既存の速度PID)を追加するカスケード構成にした。
    IMU Y軸(ロボット前後方向、+=前進、実機確認)の加速度によるフィード
    フォワードも追加。エンコーダ差分ベースの速度PID(10ms窓)より速く外乱に
    反応できる。ただし旋回中は無効化: IMUが回転中心からオフセットして
    搭載されており、旋回中は向心・接線加速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
2026-08-02 mob: HOLD/TURNを実機で試すturn_test.pyを追加、Applicationsに登録
    OLED越しにメニューからHOLD/TURN(±90/±180度)・GCALを選んで実行できる
    テストツール。実行中は角度・距離・電圧をSENから取得して表示し、
    右ボタン短押しでMOT,0,0停止、長押しで停止して終了する。
    default_appのApplicationsメニュー(実機/etc/robot-ui/applications.yaml、
    リポジトリ側はconfig/applications.yaml.example)にTurn Testとして登録。
2026-08-02 mob: 左右輪速度同期P制御を追加、turn_test.pyのUI/操作を改善
    place_controller.cppに左右輪速度の大きさ(|vr|/|vl|)をP制御で揃える
    補正を追加(HOLD/TURN共通)。モーター個体差で同じdutyでも実速度が
    揃わないと、vsumがゼロでも機体がゆっくり回頭してしまう(並進側の
    制御からは検出できない位置ズレの原因)ことへの対策。ゲイン300では
    旋回中に逆に外乱を増やしたため100へ調整(実機チューニング済み)。
    turn_test.py:
    - OLED表示をdefault_appと同じフォント・行送り規約に合わせて7行に
    収め、文字の重なりを解消。終了方法(R長押し)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
2026-08-02 mob: 旋回速度を2倍に(pivot_max_radps 3.9→7.8)
    90度旋回では元々この上限に到達しない(ピーク角速度5.4rad/s程度)ため
    実質的な影響は緩やかで、収束誤差0.24°・vsumも悪化なしを実機確認。
    角加速度(pivot_accel)は1.5倍の30も試したが目視で振動気味だったため
    20のまま据え置き。
2026-08-02 mob: 仮想ターゲット追従によるパス走行(PATTERN)を追加
    path_controller.cppを新規追加。仮想ターゲットがセグメント列(直進/
    スラローム)に沿って毎tick進み、ロボットは常にターゲットの方向を向く
    (角度)・距離30mmを保つ(速度)よう追従するpure pursuit方式。
    座標系はパス開始時のロボット位置・向きを原点とするローカル平面座標、
    オドメトリはsensors.get_distance()/get_angle()から積分する。
    直進セグメントは距離・初期/巡航/終端速度の台形速度プロファイル、
    スラロームセグメントは速度・方向・半径・角度の円弧軌道。
    PAT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
2026-08-02 mob: PATH追従の角度誤差をベアリング角からターゲット向きの差に変更
    path_controller.cppの角度誤差計算を、ロボットから見たターゲットの
    方向(ベアリング角、atan2(dy,dx))から、ロボットの向きとターゲット
    自身の向き(進行方向)の差(target_heading_rad_ - robot_theta_rad_)へ
    変更。追従距離(30mm)が旋回半径に対して無視できない比率だと、ベアリング
    角はターゲットの真の進行方向とズレる(旋回中、ロボットは追従距離の分
    だけ弧の内側/外側にずれた位置からターゲットを見ることになるため)。
    実機で方位誤差の最大値が21°→5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
2026-08-02 mob: turn_test.pyをmotion_test.pyに改名
    その場旋回(TURN)だけでなくHOLD・並進を伴うPATTERN走行も試すツールに
    なったため、"Turn Test"という名前が実態と合わなくなっていた。
    "Motion Test"に改名(default_app Applicationsメニューの表示名・実機
    /etc/robot-ui/applications.yamlも合わせて更新)。
2026-08-02 mob: motion_test.py改名に伴うドキュメント・メニュー表示の更新
    前コミットでファイル名のみリネームしていたが、docstring・
    applications.yaml.example・README.mdの記載が追従していなかった。
2026-08-02 mob: PATTERN走行パスをmob.inoのハードコードからPC側指定(PCLEAR/PADD/PRUN)へ変更
    角度はシリアル越しの桁数節約のため度(deg)指定とし、mob.ino側でradへ変換。
    将来のパターン拡張に備え、PC側でpattern.py(Straight/Slalom)経由で任意の
    区間列を組み立てて送れるようにした。motion_test.pyのPATTERNアクションも
    新プロトコル経由に変更し、実機で旧ハードコード版と同等の精度
    (目標との誤差約8mm)を確認済み。
2026-08-02 mob: PATTERN走行に位置復元力を追加し180°ターンの発散を解決、走行コマンドを即時コマンドと分離
    - 角度制御にベアリング角ブレンド(位置復元力)と追従ゲートを追加。機体の向きが
    進行方向から90°を超えて回る180°/Uターンで、target_heading制御だけでは位置を
    回復できずdist_to_targetが発散・暴走していた事象を解決。distが開くほど
    ロボット→ターゲット位置へのベアリング角へ滑らかに切り替え、それでも離れたら
    ゲートでターゲットを止めて追いつくのを待つ。90°の精度維持と180°構成の完走を
    実機で確認(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
2026-08-02 mob: PATTERNテストパスを180°Uターン含む構成・巡航390mm/s(1.3倍)に確定
    DEFAULT_TEST_PATTERNを、右90°×2(=右180°Uターン)→左90°×2(=左180°Uターン)を
    含む7区間・巡航390mm/sに更新。位置復元力(ベアリングブレンド+ゲート)により
    180°ターンでも発散せず完走することを実機確認済み。速度は600(2倍)で精度低下・
    390(1.3倍)が実用的と確認して確定。制御パラメータの微調整は継続予定。
2026-08-02 fastrun: 走行計画エンジン(Phase 1)を新規追加
    座標系・向き(geometry)、壁マップ(maze)、(セル,向き)状態のダイクストラ
    探索+直進/90°スラローム区間生成(planner)を実装。既存pattern.pyの
    Straight/Slalomを再利用し、PCLEAR/PADD/PRUNでそのまま走行できる区間列を
    出力する。直進は400mm/s目標、90°スラロームは前後の直進を半径分短縮する
    標準的な区間割り。mob_link(シリアル)・overhead(俯瞰C270撮影)・run(CLI)
    と13件のユニットテストを同梱。
2026-08-02 fastrun: 走行前カメラ初期姿勢補正(Phase 2)の推定・補正を追加
    搭載カメラで前壁赤帯の上端エッジを検出しヨー角・距離オフセットを推定
    (vision_wall.py=削除済みmicromouse/vision.pyの純numpy移植、camera_align.py=
    削除済みcamera_correction.pyの推定ロジック・較正定数を移植)。補正の実行は
    現行ファーム対応で作り直し: ヨー角はTURN(その場旋回)+SANG(絶対角上書き)、
    距離オフセットは走行計画の最初の直進へ織り込む方針(JOGFWD等は削除済みの
    ため)。OnboardCamera(Picamera2+前方固定サーボ)同梱。合成画像の
    ユニットテスト10件追加(計23件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
2026-08-02 fastrun: カメラ角度補正をジャイロ基準で再較正、閉ループalign_to_wall追加
    旧micromouse較正(gain相当0.532)はこの機体・距離では約2倍ずれており、旧
    定数で「yaw=0へ補正」すると逆に約4°ずらしていた(実機確認)。前壁正対を
    基準にTURNで既知相対角へ回しながら赤帯slopeを記録するスイープで再較正
    (slope_deg=0.248*yaw_deg+0.203、約1セル距離)。estimate_poseのヨー角式を
    更新し正対=yaw0に。距離較正は未検証のため計測のみ(走行計画へは織り込まない)。
    閉ループalign_to_wall(撮影→推定→TURN補正を反復、最後にSANG,0で基準化)を
    追加。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
2026-08-02 fastrun: 俯瞰画像をDiscordへ投稿するヘルパーを追加
    自律開発中にロボットを動かしたら移動後の俯瞰画像をDiscordへ送るための
    ヘルパー(ユーザー指示、2026-08-03)。beacon/discord_ip.pyのload_webhook_url
    を再利用しmultipartで画像POST。
2026-08-02 mob: 走行中の壁切れ検出(#WEDGE)を追加
    updatePathFollow(1kHz)で側壁センサ(ls/rs)のヒステリシス立ち上がり/
    立ち下がりを検出し #WEDGE,<L|R>,<1=rise|0=fall>,<odo_dist> を出力する。
    走行中位置補正(壁切れ補正)の較正データ収集用(挙動は不変、観測のみ)。
    WALL有効時のみ動作。PRUNのたびg_wall_edge_resetで検出器を現在値から
    初期化。閾値HIGH=200/LOW=100はSEN実測(壁あり~330/開放~10)から余裕を
    持たせた値。実機検証: 縦壁の北端を通過時 #WEDGE,R,0,186.8 が発火、
    制御ループ(WALL有効で~400us/周期増)も安定を確認。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
2026-08-03 fastrun: 壁センサ真値のセル単位迷路探索(Phase A)を追加
    floodfill(ゴールからのBFS距離+next_direction)、mapping(前/左/右壁センサ→
    絶対方向の壁マップ更新、前壁は遠いため専用しきい値FRONT_GATE=130、側壁200)、
    explorer(stop-and-read: 各セルで壁読取→地図更新→フラッドフィルで決定→
    その場旋回+1セル前進、前進の事前ゲート+走行中の前壁動的監視で衝突回避)。
    純ロジックのユニットテスト8件追加。
    実機検証: メカニクス・安全機構は正しく動作(フラッドフィル決定・旋回・前進・
    abort安全停止が2回発動し衝突回避・再決定)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
2026-08-03 fastrun: 半セル(90mm)カメラヨー較正とdrift-freeな旋回を追加
    セル・センタリング用に、前壁/側壁がマス縁にある半セル(≈90mm)距離での
    カメラ・ヨー較正を実機取得(gain=0.840, intercept=0.973, RMS=0.20°)。
    1セル用gain=0.248の約3.4倍で、ゲインが強く距離依存であることを確認。
    estimate_pose/align_to_wall に slope_gain/straight_slope 引数を追加し
    距離別の較正を切り替え可能にした。距離較正は1セル用のままなので
    is_confident に check_dist 引数を追加し、ヨー補正時は距離ゲートを外せる
    ようにした。
    あわせて、その場旋回の並進drift対策。pl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
2026-08-03 fastrun: RANG/SANGはTURN保持中に出さずstop後に発行(暴走バグ修正)
    place_controller のTURN角度追従は angle_error = turn_goal - get_angle() を
    使う。RANG/SANG は odo_ang(=get_angle())を書き換えるが turn_goal は旧角度
    フレームのまま残るため、TURN保持中にこれらを出すと angle_error が突然大きく
    なり機体が旧ゴールを追って暴れ回る。旧 _turn_by は各旋回後に stop() して
    いたため SANG は安全だったが、drift対策で hold=True 化した際に最後の旋回後
    保持が残り、続く SANG,0 が暴走を招くようになっていた(実機で確認、機体が
    コースを回って隅へ移動)。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
    [camera_align.py]
2026-08-03 CLAUDE.md: RANG/SANGはTURN保持中に出すと暴走する落とし穴を追記
2026-08-03 fastrun: 探索の前壁検出を実測に基づき修正(誤abort=破綻の主因を解消)
    前壁センサ(lf)は壁がセル境界にしか無いため実質3値と実測(2026-08-03):
    壁@90mm(前進不可)≈800、壁@270mm(1セル進めば到達)≈188、近傍壁なし≈2。
    中間値が無いので前進可否は lf>閾値 だけで判定できる。
    - FRONT_GATE 130→400: 90mm壁(~800)だけを「前進不可」とし、1.5セル先(~188)は
    拾わない。旧130は188も拾い遠い壁で前進を止める誤判定をしていた。
    - FRONT_ABORT を距離ゲート化(旧450の固定閾値バグを修正)。前壁のあるセルへ
    正常移動すると壁は到達時90mm(lf~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
    [explorer.py]
2026-08-03 前壁センサの非単調特性(近すぎ→低値)を記録し前壁検出をカメラへ寄せる方針を明記
    ユーザー指摘(2026-08-03): 前壁センサは構造上、壁が近すぎると値が下がる
    (非単調)。ある距離でピークを取りそれより近いと低下するため「近すぎる壁」と
    「遠い/開放」を値だけでは区別できない。壁が目の前にある状況では前壁センサを
    使ってはいけない。近距離前壁の確実な検出はカメラ(赤帯上端 row_at_center は
    90mmでも単調・清浄)で行う。
    - CLAUDE.md のハード構成に前壁センサの非単調特性を追記。
    - explorer.py の FRONT_GATE コメ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
2026-08-03 fastrun: カメラcrop_frac対応 + recenter.py(ヨー再ロック、WIP)
    側壁に正対して補正するとき、機体の向きによって隣の壁が中央クロップに写り込み
    フィットが壊れる(実測: 東壁=清浄、西壁=CW側で汚染)。estimate_pose/
    align_to_wall に crop_frac を追加し中央クロップを狭められるようにした。ヨーは
    赤帯slope[deg]から求まり slope はクロップ幅に不変なので、半セル較正(gain0.84)は
    そのまま使え、狭いクロップで隣壁混入だけ減らせる(距離=row_at_centerはクロップ
    幅依存なので dist 用途では要注意)。テスト+1(ヨーのcrop不変、計35件)。
    recent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
2026-08-03 mob: 直進中の側壁センサによる横位置補正(壁追従)を追加(既定無効)
    path_controller の直進セグメントで、両側に壁があるとき ls/rs 差から機体を
    迷路中心へ寄せる微小な heading バイアスを重畳する壁追従を追加。gyro heading
    制御自身がこのバイアスへ追従して中心へ寄り、寄れば(rs-ls)→0でバイアスも
    消える。robot相対(左右センサ)なので全方位で成立。
    側壁センサは角度に敏感で near-straight のときだけ信頼できる(ユーザー指摘)ため、
    直進セグメント限定・ゲイン小・バイアスをpath_wall_bias_max(既定0.10rad≈5.7°)で
    クランプ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
2026-08-03 mob: wheel_sync誤差に専用の緩いLPFを追加(旋回の結合振動対策、回帰修正)
    過去(旧motion_controller、c816154)で実証・解決済みだった対策が、2026-08-02の
    place_controller 刷新時に引き継がれず回帰していた。現行 update_wheel_sync は
    同期誤差(mag_r-mag_l)を車輪速度PID/並進制御と同じ生の速度信号(place_lpf_alpha
    ≈0.12=速い応答)からそのまま作っており、両ループが結合して旋回中に前後発振
    (→横drift)を起こす。
    旧実装に倣い、同期誤差専用の緩いLPF(place_sync_err_lpf_alpha=0.02、車輪PIDと
    約6倍の周波数帯分離)を追加し、低周波の定常ずれ(ギ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
    [params.cpp, params.h, place_controller.cpp, place_controller.h]
2026-08-03 CLAUDE.md/fastrun: ハード特性の詳細と実機開発ルールを記録、俯瞰解像度修正+ブザー通知
    ユーザー提供(2026-08-03)の詳細情報を記録:
    - 光壁センサ: 反射強度で測距、角度依存(壁が光線に90度でないと小さく出る)、
    横壁センサは真横より少し前向き(ヨーで左右非対称・前壁クロストーク)、近すぎると
    値が下がる非単調、色による反射率ばらつき、個体差。
    - ジャイロ(Z=旋回、GCALで低減・積分誤差蓄積)、エンコーダ(磁気式・平歯車バックラッシ)。
    - 搭載カメラ: サーボ0度で正面・画像利用時は必ず0度・0度未満禁止(故障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
    [notify.py, overhead.py]
2026-08-03 CLAUDE.md: 用語集を追加(ユーザー定義で統一)
    2026-08-03 ユーザーと統一した用語を用語集として記録:
    - 超信地旋回(=旧その場旋回/ピボット、mob TURN)、スラローム
    - 絶対位置(迷路上mm、原点=南西端の柱(0,0)mm、x=東/y=北、初期(90,90)mm)
    - 座標(セルindex、初期(0,0)、4x4はNE端(3,3)、セル中心=(90+180cx,90+180cy)mm)
    - オドメトリ(推定位置)、壁センサフィードバック制御、壁切れ補正
    (=内部情報の更新)、壁上面位置補正(=カメラでマス中心へ移動)
    - 旋回横drift、ヨー/横位置/前後位置、俯瞰の方位(上=北・右=東・下=南・左=西、実機確認)
    Co-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
2026-08-03 mob: 停止中はジャイロ角度積分を凍結+積分にGCALオフセットを適用
    ユーザー指摘(2026-08-03): ロボットには基本的に外力が加わらず、モーター停止中は
    移動しないし角度も変化しない。よって停止中はジャイロ積分を止めてよい。
    セッション中のheadingドリフトの多くは、撮影・待機など静止中に残留バイアスを
    積分し続けた分だった。
    - Motor に last_right_/last_left_ と is_stopped()(両出力0=停止中)を追加。
    - Sensors に stationary_ フラグと set_stationary() を追加。update() で停止中は
    角度積分(delta_angle)を0にして凍結(距離はエンコー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
2026-08-03 fastrun: B(カメラでヨーを絶対方位へ貼り直す reanchor_heading)を実装
    壁上面位置補正の土台。既知マスの既知の壁に正対してヨーを較正し、SANGで
    heading を絶対方位(北=0/西=+90/東=-90/南=±180)へ貼り直す。gyroドリフト対策。
    - turn_to(超信地旋回・odoフィードバックで目標方位へ)
    - reanchor_heading(方位へ向く→align_to_wall(半セルcrop0.3)で正対→is_confidentで
    ゲート→stop→SANG)
    - CAMERA_ROW_PX_PER_MM=5.38(距離較正)とHEADING_*定数を追加。
    実機検証: 東向き(odo -90)から西壁へreanchor→odo_ang +89.95(≈真西)・西壁カメラ
    yaw+0.53°(≈0=正対確認)。停止8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
2026-08-03 fastrun/CLAUDE.md: 旋回の左右バランス(ケーブルよじれ対策)を追加
    ユーザー指摘(2026-08-03): 上から電源ケーブルが来ており、同方向にばかり
    超信地旋回するとケーブルがよじれる。
    - recenter に正味物理回転量の追跡(_net_phys_deg、_hold_turnで累積。RANG/SANGで
    odo_angがリセットされても物理回転は追える)、net_rotation_deg()/
    reset_net_rotation()/unwind_cable() を追加。
    - turn_to は方向が曖昧な旋回(|err|>150°、180°往復等)ではよじれを減らす向きを
    選ぶ(明確に短い旋回は最短のまま=無駄な大回転を避ける)。
    - CLAUDE.md 開発ルールに左右バラ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
    [recenter.py]
2026-08-03 fastrun/CLAUDE.md: 治具中心での精密真値(row@90mm=689.9, lf=890, ls=351)を記録
    ユーザーが専用治具でロボットを(1,1)中心・西向きに正確固定して取得した精密な
    真値(2026-08-03):
    - 搭載カメラ赤帯 row_at_center は壁90mmで 689.9(crop0.3, res<=0.38, n=10)。
    recenter.CAMERA_ROW_AT_90MM として追加。壁上面位置補正の位置成分の絶対基準
    ((row-689.9)/5.38 [mm] で壁までのマス中心からのずれ)。
    - 壁センサ精密値: 前壁90mmで lf=890、側壁90mmで ls=351。CLAUDE.mdに追記。
2026-08-03 mob: 停止中角度積分の凍結を能動制御中は無効化(旋回発振の修正)
    is_stopped()(瞬間duty=0)で角度積分を凍結すると、超信地旋回の減速〜
    角度保持で duty が正当に0を通過するたびに角度が凍り、実回転を取りこぼす。
    角度FBにデッドゾーンが入りリミットサイクル(発振)→タイヤ滑りで15-20mm
    物理移動していた(2405a29の回帰)。凍結を motion_state でゲートし、
    PLACE_HOLD/PATH_FOLLOW中は凍結しない(真の停車時のみ凍結)。
    検証: TURN +90/-90で整定角度p2p=0.006〜0.029deg(発振消失)、俯瞰カメラで
    2回旋回の物理移動8.7mm(従来15-20mm/回から大幅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
    [mob.ino]
2026-08-03 fastrun: 壁上面位置補正の位置成分の推定を治具検証済み定数で実装(推定のみ)
    recenter.py に前後オフセット推定を追加:
    - forward_offset_from_row / forward_offset_from_image(純関数、テスト可能)
    - estimate_forward_offset(搭載カメラ、撮影のみ=移動しない=安全)
    治具検証済み CAMERA_ROW_PX_PER_MM=5.38 / CAMERA_ROW_AT_90MM=689.9(crop0.3)を使う。
    残差・オフセット範囲(±45mm)の信頼度ゲートで誤検出を弾く。実際の前後移動は
    含めず監督下で行う(壁への前進は無人実行しない)。
    camera_align.py: 旧micromouseの stale 距離定数(11.599 px/mm、現行の約2倍ずれ)に
    警告注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
2026-08-03 mob: JOG系コマンド(JOGFWD/JOGBACK/JOGTURN)を実装
    壁上面位置補正の位置成分など、精密な微小前後移動プリミティブを再導入。
    現行アーキテクチャ(発振修正済みplace_controller)を再利用:
    - JOGFWD/JOGBACK,<mm>: start_move()。pos_refを±mmずらす位置P制御(place_pos_max_mps
    で低速クランプ≈本体25mm/s)で滑らかに到達し、旋回制御で開始時のヨーを保持。
    到達・整定でDONE、以降も位置・向きを保持(停止はMOT,0,0)。
    - JOGTURN,<rad>: start_turn(as_jog=true)。既存の台形旋回に到達DONEを追加。
    place_controllerにJogKind状態と take_jog_arrived() を追加、mob.inoが毎tic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
    [mob.ino, place_controller.cpp, place_controller.h]
2026-08-03 CLAUDE.md: JOG系コマンド(JOGFWD/JOGBACK/JOGTURN)の再導入を反映
    移動系コマンド一覧を更新。JOGだけは例外的に到達・整定でDONEを返す旨も明記。
2026-08-04 fastrun: 前壁への接近+中心化(壁上面位置補正の位置成分)をrecenter.pyに実装
    実走検証済み(2026-08-04、90mmから1.6mmずれまで中心化)の閉ループを関数化:
    - center_on_front_wall: (1)row駆動の接近でrowを近距離域(≈690=90mm)へ寄せ、
    (2)近距離域でmm較正を使いJOGFWD/JOGBACKで offset→0 に微調整。
    - approach_step_mm(純関数): rowに応じた適応ステップ(遠30mm→近6mm)。
    - measure_front_row / _jog(JOG DONE待ち)。
    安全: res>閾(汚染)・検出不能・総前進上限・row上限(近すぎ→後退)で中断。
    重要知見: row→距離のmm較正は90mm付近でしか有効でない(遠近法で非線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
2026-08-04 fastrun/CLAUDE.md: L0足場 — RoboSweep/Liner/Eiffel枠組み明記 + 開発用4×4既知迷路
    CLAUDE.md: プロジェクト像を明確化。競技=RoboSweep(マイクロマウスではない)、
    この機体=走行エージェントLiner、俯瞰視覚エージェントEiffelが既知迷路+ボール座標を
    供給し探索不要。Linerの目標ループ(座標へ高速移動→マス中心へ壁上面補正)を記載。
    dev_maze.py: 開発用4×4迷路の既知壁マップ(内壁7本)を俯瞰(Eiffel代理)から
    各グリッド辺の明度で自動判定して固定。build_dev_maze()/render_ascii()。
    検出壁を画像へオーバーレイして全て実壁と一致を確認。te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
2026-08-04 fastrun: L0 — Liner姿勢モジュール(liner_pose.py)
    LinerPose(セル座標cx,cy+向きheading)と座標変換: center_mm(絶対位置=90+180·c)、
    heading_deg(ジャイロ/SANG系: 北0/西+90/東-90/南180=recenter規約)、moved/advanced/
    facing。RoboSweepのLinerが座標間移動中に自己姿勢を追う土台。test 8件(全60件パス)。
2026-08-04 fastrun: L1 — マス中心化ルーチン(liner_center.py)の骨格
    壁上面補正で Liner をマス中心へ戻す(両軸)。検証済み要素を組み合わせ:
    - center_axis(link,cam,face): face の壁へ turn_to→center_on_front_wall(位置90mm)
    →reanchor_heading(ヨー絶対化)。1軸+ヨーを補正。
    - recenter_cell(link,cam,maze,pose): 現在セルで使える面をmazeから選びX/Y両軸を補正。
    - available_faces/neighbor_for_axis(純関数): 使える壁の選択・壁欠如時の近傍探索。
    近傍フォールバックの移動は L2 の後に接続。純ロジックのtest 6件(全66件パス)。
2026-08-04 fastrun: L2 go_to のodo基準バグを修正(RANG起因)
    2点修正(いずれも実機で判明):
    1. turn_to(初手旋回)直後にRANGを出すとTURN保持中のRANGで暴走する既知バグ
    (CLAUDE.md)。turn_to後にMOT,0,0で保持を抜けてからPRUNへ移る。
    2. reset_odometry(RANG/RDST)自体を削除。path_controller.start()が
    start_heading_rad_=get_angle()を捕捉し相対角度で走る(自己参照)ため不要。
    RANGすると絶対ヨー基準(カメラreanchorで確定)が到達時の物理向きで上書き
    され、後続のrecenter_cellのturn_to(絶対odo依存)が狂う。odo_angは移動後も
    絶対のまま保たれる。診断で turn_to→odo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
    [liner_move.py]
2026-08-04 fastrun: center_on_front_wall に壁近すぎ時の後退リカバリを追加
    高速移動のオーバーシュート等で到達時に壁へ寄りすぎ、赤エッジが枠外/未検出に
    なると中心化が失敗する(実機で(3,3)角到達後に確認)。expect_wall=True(既知の
    壁がある前提)なら、未検出/汚染時に BACKOFF_CAP まで少しずつ後退して壁を視野に
    入れてから中心化する。center_axis(mazeから壁ありと分かって呼ぶ)は既定で有効。
2026-08-04 fastrun: 赤壁 下端エッジ検出アダプタ(wall_bottom.py)を追加
    上端エッジ(vision_wall)は迷路外の背景色に汚染されうる。下端エッジ(赤い上面と
    白い壁面=迷路内側の境界)は背景に強い(ユーザー方針)。既存の下端検出アルゴリズム
    software/vision/wall.py(HSV+RANSAC)を再利用し、現行RedBandEdge(slope=a,intercept=b,
    inlier_count,residual_std)互換で返す detect_red_band_bottom_edge を実装。信頼度ゲート用に
    残差std/インライア数も算出。make_maskはBGR前提なのでRGB→BGR反転して渡す。合成画像
    テスト4件(下端検出・傾き・手前選択・赤なし)。
    ⚠️ 下端は上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
2026-08-04 fastrun: 壁上面補正の位置成分を下端エッジへ切替+実機再較正
    背景汚染に弱い上端エッジ→迷路内側で完結する下端エッジ(wall_bottom)へ、位置成分
    (center_on_front_wall/forward_offset_from_image)を切替(ユーザー方針)。(1,3)平らな
    北壁で上端(較正済)を真距離基準に下端を実機再較正:
    - CAMERA_ROW_AT_90MM: 689.9→841.5、CAMERA_ROW_PX_PER_MM: 5.38→7.647(下端は高感度)
    - ROW_NEAR_STOP 650→800、ROW_TOO_CLOSE 720→880、approach_step しきい値を下端row基準へ
    - forward_offset_from_image を detect_red_band_bottom_edge に
    実機検証: center_on_front_wall(下端)で offset+3.26mm・res0.74、上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
2026-08-04 fastrun: 壁上面補正のヨー成分も下端エッジへ切替+ヨーgain実機再較正
    位置成分に続きヨー成分(reanchor_heading/relock_heading)を下端エッジへ切替。
    (1,3)平らな北壁で、前回正対時のSANG,0がジャイロ凍結で保持された状態を正対基準に
    ±6°掃引して下端ヨーgainを再較正(7/7清浄、fit RMS=0.126°):
    - SLOPE_DEG_PER_YAW_DEG_HALFCELL_BOTTOM=0.6871(上端0.84)
    - STRAIGHT_SLOPE_DEG_HALFCELL_BOTTOM=0.8870(上端0.973)
    estimate_pose/align_to_wall に detector 引数を追加(既定は上端で後方互換)、
    reanchor/relockは下端検出器+下端gainを渡す。
    ★照明頑健性を実証: 暗い赤み照明で上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
2026-08-04 fastrun: 壁上面補正に距離認識モデル(camera_model)を統合+オープンループ化
    治具較正(75〜115mm・±18°)で、row↔距離・yaw gain↔距離・straight↔距離が
    いずれも非線形(近いほど高感度)と判明。90mm付近だけの線形較正では近接で
    px/mmが約2倍過小・gainが約13%過大となり、オープンループ補正の残差が
    12〜19mmと出ていた。区分線形補間の距離認識モデル camera_model.py を新設し、
    壁上面補正の位置・角度両成分をこれ経由に切替。
    - camera_model.py(新規): distance_from_row/gain_at/straight_at/estimate/
    forward_offset_mm。治具較正点の区分線形補間(num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
2026-08-04 mob: JOG前後移動を高速化(place_pos_kp/max引き上げ)
    JOGFWD/JOGBACK が本体≈25mm/sと遅く、低速域で静止摩擦・バックラッシにより
    制御性が悪かった(ユーザー指摘)。位置ホールド外側ループのゲインを
    place_pos_kp 2.0→6.0、place_pos_max_mps 0.05→0.14(和=0.14 → 本体巡航≈70mm/s)
    へ引き上げ。
    PSETライブ掃引で 4.0/0.10・6.0/0.14・8.0/0.18 を60mm往復で比較し 6.0/0.14 を選定:
    60mm往復が総2.3s→1.6s、巡航≈75mm/s(旧25mm/sの約3倍)、オーバーシュート無し・
    方向逆行0。共用先の HOLD 静止保持(odo_dist p2p 0.11mm)・旋回後保持(並進
    p2p 0.26mm)も発振しないこ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
2026-08-04 fastrun: 次エージェント向け引き継ぎドキュメント(HANDOFF.md)を追加
    現状(壁上面補正の距離認識モデル統合・JOG高速化)と、ロボットの動かし方
    (シリアル/移動コマンド/安全ルール/壁上面補正の実行/params NVS注意)、
    次の最優先ステップ(壁上面補正の end-to-end 実機検証)をまとめた。
2026-08-04 fastrun: HANDOFF.mdにmemoryの重要事項を追記
    俯瞰カメラの具体的な使い方(/dev/video4・1280x960必須・overhead.capture_and_post
    でVGA Discord投稿)、座標系/方位規約(北0/西+90/東-90/南±180)、壁上面補正の
    既知の落とし穴(角の∧問題・カメラ汚染・YAW_GATE15°・近距離限界72mm・odo回復知見)、
    横位置の壁追従(path_wall_kp)選択肢、makeのcwd移動トラップ、環境変更はユーザー管理、
    を追加。
2026-08-04 mob: JOGと並進抑制のPIDパラメータを分離
2026-08-04 mob: LPFカットオフ1/3化・旋回速度8割・加速度8割
2026-08-04 fastrun: recenter JOGログ追加・heading初期化・較正範囲外自動接近/離脱
2026-08-04 camera: camera_test エッジ描画色を赤→青に変更
2026-08-05 mob: PATTERN前に壁上面補正し北向き復帰
2026-08-05 mob: PATTERN とホイール直径の調整
2026-08-05 mob: NVS保存パラメータをソースデフォルトに反映、ターゲット追従の角度制御改善
2026-08-05 fastrun: 壁上面補正のパフォーマンス計測ログを追加
2026-08-05 fastrun: 壁上面補正で JOGTURN から TURN に変更（タイムアウト対策）
2026-08-05 fastrun: measure_wall のフレーム数を 6 → 4 に削減
2026-08-05 fastrun: 壁上面補正の詳細パフォーマンスログとTURN待機1秒化
2026-08-05 mob: JOGFWD/JOGBACK の速度上限を2倍化
2026-08-07 mob: Kanayama式横位置復元力path_ky導入、ホイール直径を23.0mmへ統一
2026-08-07 fastrun: 8方向斜め走行(Phase 4b)と時間見積り精緻化(Phase 4a)、実機検証スクリプト追加
2026-08-07 fastrun: 走行精度検証の閉ループパターン verify_loop.py を追加(45°+斜め+90°R/L、実機ベースライン取得)
2026-08-07 docs: 用語集にオドメトリ基準の値/真の物理位置/真の物理誤差を追加、精度向上の3段階方針を明記
2026-08-07 mob: path_controller の横復元を直進限定+ライン基準lat_err化、VERコマンドでファームバージョン応答を追加(0.4.0)
2026-08-07 fastrun: verify_loop の閉ループ経路をターゲット先読み補償(seg0/seg10)、クロストラック集計・PSET対応を追加
2026-08-07 docs: 用語集にスタート位置を追加
2026-08-08 mob: path_controller にスラローム曲率先読み補正を追加、VER を 0.4.1 に更新
2026-08-08 fastrun: verify_loop に走行後180°旋回のスタート位置復帰を追加
2026-08-08 fastrun: verify_loop の既定速度を直進700/スラローム550 mm/sに更新(実機検証で確定)
2026-08-08 fastrun: マス列から走行パターンを生成する pattern_from_cells を追加(WIP)
2026-08-08 fastrun: pattern_from_cells に斜めショートカット(k≥2の交互ターン階段を45°スラローム+斜め直進に置換、壁クリアランスゲート付き)を追加、マス列実機検証スクリプト verify_cells を追加
2026-08-09 mob: PATH_FOLLOWに衝突検出を追加(位置/角度誤差の持続逸脱でモータ停止+#COLLIDE通知、FW 0.4.2)。verify_cellsに#COLLIDE受信と#T閾値の二重監視、閾値変更手順をCLAUDE.md/READMEに記載
2026-08-30 fastrun: Eiffel連携の設計とeiffel_client(combined 16×8→WallMap)を追加
    Eiffel(視覚エージェント)の /status.json から迷路情報を取得しLinerのWallMapへ
    変換する薄い層。実機two-unit-networkブランチの契約で確定:
    - 1号機(role=primary)の combined フィールド(2台マージ済み・グローバル座標16×8)を読む
    - 座標系はLinerと一致(原点=南西, col=cx=東, row=cy=北)。変換不要
    - 未検出マスは walls_valid=全falseで埋まる→validな辺だけ信頼、conservativeで未知内辺を封鎖
    - 外周辺のinvalidは無視(WallMapが外周を常に壁扱い)
    stdlib(urllib)のみ。設計はDESIGN_eiffel_liner.md。実/s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
2026-08-30 fastrun: mission(Eiffel経路走行、走行前recenter)とdrive_runner切出しを追加
    ゴール座標→Eiffel取得→経路計画→走り出す前にrecenter→高速移動→到達でrecenter。
    - mission.py: run_mission状態遷移。find_path/planで経路、到達不能・範囲外・経路上
    未検出はMissionErrorで中止。recenter_before_driveでスタートセルをマス中心・正対に
    確定(verify_loop.recenter_startを任意セル・向き・WallMap対応に一般化)後に走行
    - drive_runner.py: verify_cellsの走行/監視/発振要約をdrive_segments()に切出し(挙動不変)
    - mission.yaml: Eiffel接続/スタート(0,7)南/速度/衝突しきい値
    実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
2026-08-30 fastrun: goto_ball(ボール検出→経路決定→走行)を追加、missionにsnap受け渡し
    Eiffelのcombined.ballsからボール位置を検出し、自陣内で到達可能な最寄りボールへ
    走行前recenter付きで移動する一体プログラム。実機検証済み((0,7)S→検出ボール(3,4)完走)。
    - goto_ball.py: 複数フレームで過半数観測のボールのみ採用(検出ノイズ対策)、find_pathで
    到達可能に絞り nearest/most-yellow で選択、run_mission で走行。到達recenterは既定OFF
    (ボールを押さない)
    - mission.run_mission: 取得済みスナップショットを受け取る snap 引数を追加(検出と走行で
    同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
    [goto_ball.py, mission.py]
2026-11-03 micromouse: 壁センサフィードバック制御の追加とコード改善
2026-11-03 mob,micromouse: PRUN完了時にDONE送信、最短走行でも壁センサフィードバックを有効化
    - mob.ino: path_controller完了時にDONEを送信する機能を追加
    - mobile_base.py: forward_with_wall_feedback()を簡素化(DONE受信で完了検出)
    - cell_runner.py: run_motion(STRAIGHT)でも壁センサフィードバックを有効化
    - test_mobile_base.py: PRUNのDONE応答を追加、テストを簡素化
